illiapliukhin/leds/hardware/analysis/MATRIX_ROUTING_FEASIBILITY.md

# Matrix routing feasibility

Status: all local orientation probes and the complete repeated 20×20 and 28×28 LED matrices pass KiCad 10 DRC. The complete matrices have zero violations and zero unconnected items. Driver exits, backside placement, and the L2 ground zone are not included.

## Verified artifacts

- `wearable_20x20_edge_routing_probe.kicad_pcb`
- `wearable_20x20_edge_routing_probe_drc.rpt`
- `wearable_28x28_edge_routing_probe.kicad_pcb`
- `wearable_28x28_edge_routing_probe_drc.rpt`
- `wearable_20x20_bottom_right_routing_probe.kicad_pcb`
- `wearable_20x20_bottom_right_routing_probe_drc.rpt`
- `wearable_28x28_bottom_right_routing_probe.kicad_pcb`
- `wearable_28x28_bottom_right_routing_probe_drc.rpt`
- `wearable_20x20_orientation_transition_routing_probe.kicad_pcb`
- `wearable_20x20_orientation_transition_routing_probe_drc.rpt`
- `wearable_28x28_orientation_transition_routing_probe.kicad_pcb`
- `wearable_28x28_orientation_transition_routing_probe_drc.rpt`
- `wearable_20x20_top_right_routing_probe.kicad_pcb`
- `wearable_20x20_top_right_routing_probe_drc.rpt`
- `wearable_20x20_bottom_left_routing_probe.kicad_pcb`
- `wearable_20x20_bottom_left_routing_probe_drc.rpt`
- `wearable_28x28_top_right_routing_probe.kicad_pcb`
- `wearable_28x28_top_right_routing_probe_drc.rpt`
- `wearable_28x28_bottom_left_routing_probe.kicad_pcb`
- `wearable_28x28_bottom_left_routing_probe_drc.rpt`
- `wearable_20x20_top_right_column_boundary_routing_probe.kicad_pcb`
- `wearable_20x20_top_right_column_boundary_routing_probe_drc.rpt`
- `wearable_20x20_bottom_left_column_boundary_routing_probe.kicad_pcb`
- `wearable_20x20_bottom_left_column_boundary_routing_probe_drc.rpt`
- `wearable_28x28_top_right_column_boundary_routing_probe.kicad_pcb`
- `wearable_28x28_top_right_column_boundary_routing_probe_drc.rpt`
- `wearable_28x28_bottom_left_column_boundary_routing_probe.kicad_pcb`
- `wearable_28x28_bottom_left_column_boundary_routing_probe_drc.rpt`
- `wearable_20x20_top_right_row_boundary_routing_probe.kicad_pcb`
- `wearable_20x20_top_right_row_boundary_routing_probe_drc.rpt`
- `wearable_20x20_bottom_left_row_boundary_routing_probe.kicad_pcb`
- `wearable_20x20_bottom_left_row_boundary_routing_probe_drc.rpt`
- `wearable_28x28_top_right_row_boundary_routing_probe.kicad_pcb`
- `wearable_28x28_top_right_row_boundary_routing_probe_drc.rpt`
- `wearable_28x28_bottom_left_row_boundary_routing_probe.kicad_pcb`
- `wearable_28x28_bottom_left_row_boundary_routing_probe_drc.rpt`
- `wearable_20x20_full_matrix_routing.kicad_pcb`
- `wearable_20x20_full_matrix_routing_drc.rpt`
- `wearable_28x28_full_matrix_routing.kicad_pcb`
- `wearable_28x28_full_matrix_routing_drc.rpt`
- Generator: `hardware/tools/generate_edge_routing_probe.py`
- Boundary generator: `hardware/tools/generate_orientation_boundary_probes.py`
- Full-matrix generator: `hardware/tools/generate_full_matrix_routing.py`

All 18 local-probe DRC reports contain zero geometric violations. They still report 499 unconnected groups because only four LEDs are routed in each probe. Both full-matrix reports contain `Found 0 DRC violations` and `Found 0 unconnected pads`.

## DRC-proven local pattern

- L1 carries only short LED-pad escape segments.
- Every RGB cathode transitions to L4 with a 0.40/0.20 mm through via.
- L4 carries three 0.10 mm vertical RGB trunks per column.
- Each trunk is offset 0.375 mm from the optical center or runs through the center.
- Every common anode transitions to L3 with a 0.45/0.20 mm through via.
- Interior L3 row buses are 1.20 mm wide.
- The top edge row bus is 0.40 mm wide and centered 0.525 mm from the routed edge.
- Local copper clearance is 0.10 mm.
- Hole-to-copper clearance is 0.20 mm.
- Copper-to-edge clearance is at least 0.30 mm.

The same top-left topology passes at 2.50 mm and 2.20 mm pitch without microvias, blind/buried vias, or via-in-pad.

The bottom-right probe rotates the final two LED rows by 180 degrees and mirrors the escape inward:

- RGB transition vias are above each rotated LED;
- the bottom L3 row bus is 0.40 mm wide and centered 0.525 mm from the edge;
- anode vias escape to the left, including at the rightmost column;
- the same 0.40/0.20 mm RGB and 0.45/0.20 mm anode vias are retained.

The orientation-transition probe uses a normal upper row and a 180-degree lower row. Rotating the footprint reverses the lateral G/R pad order, so three shared RGB vias cannot connect both rows on one copper layer without a crossover. The DRC-proven transition uses:

- one shared blue via per column;
- separate upper and lower G/R vias, for five RGB vias per transition column;
- a local G crossover on L3 and an R crossover on L4;
- a 0.40 mm local neck in each L3 row bus through the transition cell.

The normal 1.20 mm interior row-bus width resumes outside the transition cell. All row buses now use KiCad `In2.Cu`, the physical L3 layer; `In1.Cu` remains reserved for the L2 ground plane.

The mirrored corners require corner-specific quarter-turn orientations:

- top-right LEDs use 90 degrees, with G/B side escapes and a central R escape toward the board interior;
- bottom-left LEDs use 270 degrees with the same topology mirrored vertically;
- anode vias escape inward, retaining the standard 0.45/0.20 mm geometry.

The DRC-proven global orientation map is:

- 0 degrees across the upper interior half;
- 180 degrees across the lower interior half;
- 90 degrees along the upper right edge, transitioning to 180 degrees below;
- 270 degrees along the lower left edge, transitioning from 0 degrees above.

Column-boundary probes prove the upper `0°|90°` and lower `270°|180°` junctions. Row-boundary probes prove the right-edge `90°→180°` and left-edge `0°→270°` junctions. Each edge row transition uses five RGB vias per column: one shared G via and separate B/R vias joined through orthogonal L3/L4 crossover corridors. The two local L3 row buses remain 0.40 mm wide. Both pitches pass without using L2 copper.

## Complete repeated matrix

The full-matrix generator expands the proven orientation map across every LED while adapting the midpoint transitions to the neighboring trunks:

- generation always starts from a clean in-memory skeleton and never consumes
  the working production PCB, so repeated runs cannot duplicate matrix copper;
- `generate_board_skeletons.py` writes reviewable skeletons under
  `hardware/analysis` instead of overwriting working boards;
- generated board/items receive deterministic KiCad UUIDs, and
  `verify_matrix_generation.py` compares SHA-256 across two complete runs
  before applying the promotion topology checks;
- standard midpoint cells keep G on L3, R on L4, and B continuity on L1;
- edge midpoint cells use one L3 crossover, one short L4 crossover, and separated L4 doglegs around the row vias;
- regular L4 RGB trunks resume outside each transition cell;
- all row buses remain on L3, with only short L1 anode escapes;
- L2 contains no generated tracks.

KiCad semantic checks confirm:

| Check | 20×20 | 28×28 |
|---|---:|---:|
| LED footprints | 400 | 784 |
| Total through vias | 1,564 | 3,084 |
| Row vias, 0.45/0.20 mm | 400 | 784 |
| RGB vias, 0.40/0.20 mm | 1,164 | 2,300 |
| Row nets present on L3 | 20 | 28 |
| Tracks on L2 | 0 | 0 |

The orientation counts are 180/20/180/20 for 0°/90°/180°/270° on 20×20 and 364/28/364/28 on 28×28. Every generated via is a standard through via with a 0.20 mm drill. Promotion rejects any mismatch in LED-only footprint scope, orientation counts, total tracks/vias, 0.40/0.45 mm via counts, drill size, L3 row-net coverage, L2 occupancy, or connectivity.

## Preliminary electrical estimate

Assumptions:

- copper resistivity: 1.724 × 10⁻⁸ Ω·m;
- L3 inner copper: conservative 17.5 µm;
- L4 outer copper: 35 µm;
- row current: 0.60 A for 20×20 and 0.84 A for 28×28;
- current is distributed uniformly along a row and fed from one end;
- one active LED color channel carries 10 mA.

| Case | Approximate conductor resistance | Distributed-load far-end drop |
|---|---:|---:|
| 20×20, 0.40 mm outer row | 0.117 Ω | 35 mV |
| 20×20, 1.20 mm interior row | 0.039 Ω | 12 mV |
| 28×28, 0.40 mm outer row | 0.146 Ω | 61 mV |
| 28×28, 1.20 mm interior row | 0.049 Ω | 21 mV |
| 28×28, 0.10 mm RGB trunk | 0.293 Ω | 2.9 mV at 10 mA |

These are first-order copper-only estimates. PMOS, connector, via, plane-spreading, converter ripple, copper-thickness tolerance, and temperature are excluded. Feed rows from both ends if backside placement permits; otherwise confirm the farthest blue pixel at maximum row current during EVT.

## Density and production impact

The DRC-clean repeated topology uses fewer than four matrix vias per LED because midpoint transition cells share or avoid selected RGB vias:

- 20×20: 1,564 matrix vias;
- 28×28: 3,084 matrix vias.

This is a conventional through-via process but creates substantial L2 ground-plane perforation and drill count. Before production layout:

1. confirm JLCPCB accepts the repeated 0.40/0.20 mm vias at quoted yield;
2. inspect L2 neck widths and return-current continuity after antipads;
3. reserve L4 vertical channels from backside component pads;
4. add row feeds and RGB driver exits without blocking the proven corridors;
5. compare against a lower-via interior pattern only if it remains simpler and DRC-clean.

`hardware/tools/add_l2_ground_plane.py` generates a non-production 20×20
probe with a 0.30 mm edge inset and 0.10 mm clearance/minimum thickness.
After all 1,564 matrix-via antipads are applied, KiCad reports one contiguous
fill outline, 1,919.9 mm² of copper, and 81.0% coverage of the nominal zone.
The probe intentionally retains an isolated-copper warning because no
backside GND pad exists yet. This proves gross geometric continuity only; it
does not prove electrical grounding, local return-path quality, or minimum
neck width after component placement.

## Release gate

Do not treat the DRC-clean repeated matrix as production output until:

- row feeds, driver exits, and backside placement are included;
- L2 plane continuity is reviewed visually and by field-current inspection;
- voltage-drop assumptions are checked against the selected supplier stackup.
