illiapliukhin/leds/hardware/analysis/POWER_SCAN_MODEL.md

# Wearable RGB power and scan model

Generated by `hardware/tools/model_power_scan.py`.

## Assumptions

- LED rail: 4.099 V.
- Peak channel current: 9.41 mA.
- Six color-homogeneous drivers and 96 serialized bits per row.
- Physical PWM depth: 6 bits.
- SPI clock: 20.0 MHz.
- Row transition dead time: 1.5 us per bit-plane row.
- AO3403 preliminary worst-case resistance: 200 mOhm.
- Battery-current and converter-temperature calculations use 90% efficiency at 3.15 V.
- TPS63802 open-board temperature rise uses datasheet RthetaJA = 81 C/W. It is not an enclosure prediction.

## Results

| Variant | Row current | LED rail power | PMOS drop | Battery current at 3.15 V | LSB / MSB hold | 1 W brightness cap |
|---|---:|---:|---:|---:|---:|---:|
| wearable_20x20 | 0.565 A | 2.32 W | 113 mV | 0.82 A | 3.94 / 125.9 us | 43% |
| wearable_28x28 | 0.791 A | 3.24 W | 158 mV | 1.14 A | 4.33 / 138.5 us | 31% |

## Engineering conclusions

- Full-white operation exceeds the 1–1.2 W wearable continuous target on both variants. Global brightness and content-aware power limiting are mandatory.
- The high-resolution variant needs roughly 1.14 A from a 3.15 V battery at the assumed efficiency. Battery, connector, charger power path, copper, and converter transients must support this pulse current.
- The conservative AO3403 drop is large enough to affect LED headroom. Measure row voltage and color current at hot and cold temperature before freezing LED_4V1.
- The 20 MHz scan timing budget remains positive with 1.5 us break-before-make dead time. Confirm the dead time from gate and row waveforms on EVT.
- Converter junction-rise values are screening estimates only. Use enclosure thermal measurements to set firmware derating.
