illiapliukhin/leds/hardware/analysis/power_scan_results.csv

variant | peak_row_current_a | led_rail_power_w | pmos_drop_v | aggregate_pmos_loss_w | shift_time_per_frame_us | blank_time_per_frame_us | lsb_hold_time_us | msb_hold_time_us | battery_current_min_v_a | converter_loss_w | converter_open_board_rise_c | brightness_limit_at_1w | brightness_limit_at_1_2w
wearable_20x20 | 0.564795918367347 | 2.3150984693877557 | 0.11295918367346941 | 0.06379888588088299 | 576.0 | 180.0 | 3.93514739229025 | 125.924716553288 | 0.8166132167152578 | 0.2572331632653063 | 20.835886224489812 | 0.43194706973498936 | 0.5183364836819871
wearable_28x28 | 0.7907142857142857 | 3.2411378571428573 | 0.15814285714285714 | 0.1250458163265306 | 806.4 | 252.0 | 4.3295080350980975 | 138.54425712313912 | 1.1432585034013607 | 0.36012642857142874 | 29.17024071428573 | 0.3085336212392782 | 0.3702403454871338
