illiapliukhin/leds/hardware/wearable_28x28/wearable_28x28.kicad_pcb

## KiCad design hardware/wearable_28x28/wearable_28x28.kicad_pcb (2026-10-08)

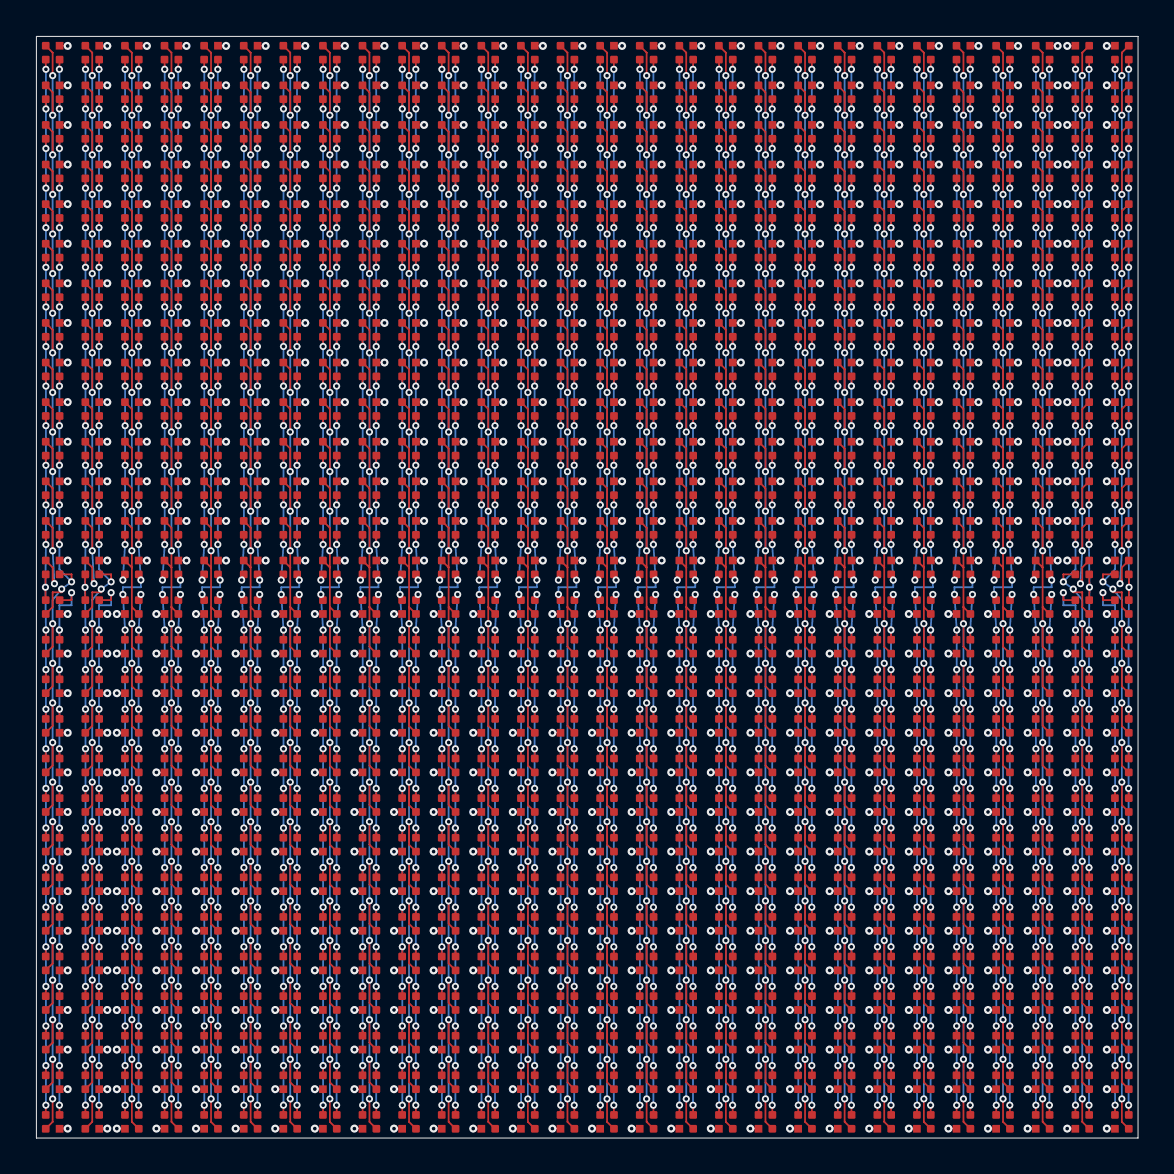
[picture p3: board wearable_28x28.kicad_pcb from above]

Board: 4 copper layers, 61.2 x 61.2 mm, 784 parts (0 on the bottom side), 112 nets.

Parts:
D1, D2, D3, D4, D5, D6, D7, D8, D9, D10, D11, D12, D13, D14, D15, D16, D17, D18, D19, D20, D21, D22, D23, D24, D25, D26, D27, D28, D29, D30, D31, D32, D33, D34, D35, D36, D37, D38, D39, D40, D41, D42, D43, D44, D45, D46, D47, D48, D49, D50, D51, D52, D53, D54, D55, D56, D57, D58, D59, D60, D61, D62, D63, D64, D65, D66, D67, D68, D69, D70, D71, D72, D73, D74, D75, D76, D77, D78, D79, D80, D81, D82, D83, D84, D85, D86, D87, D88, D89, D90, D91, D92, D93, D94, D95, D96, D97, D98, D99, D100, D101, D102, D103, D104, D105, D106, D107, D108, D109, D110, D111, D112, D113, D114, D115, D116, D117, D118, D119, D120, D121, D122, D123, D124, D125, D126, D127, D128, D129, D130, D131, D132, D133, D134, D135, D136, D137, D138, D139, D140, D141, D142, D143, D144, D145, D146, D147, D148, D149, D150, D151, D152, D153, D154, D155, D156, D157, D158, D159, D160, D161, D162, D163, D164, D165, D166, D167, D168, D169, D170, D171, D172, D173, D174, D175, D176, D177, D178, D179, D180, D181, D182, D183, D184, D185, D186, D187, D188, D189, D190, D191, D192, D193, D194, D195, D196, D197, D198, D199, D200, D201, D202, D203, D204, D205, D206, D207, D208, D209, D210, D211, D212, D213, D214, D215, D216, D217, D218, D219, D220, D221, D222, D223, D224, D225, D226, D227, D228, D229, D230, D231, D232, D233, D234, D235, D236, D237, D238, D239, D240, D241, D242, D243, D244, D245, D246, D247, D248, D249, D250, D251, D252, D253, D254, D255, D256, D257, D258, D259, D260, D261, D262, D263, D264, D265, D266, D267, D268, D269, D270, D271, D272, D273, D274, D275, D276, D277, D278, D279, D280, D281, D282, D283, D284, D285, D286, D287, D288, D289, D290, D291, D292, D293, D294, D295, D296, D297, D298, D299, D300, D301, D302, D303, D304, D305, D306, D307, D308, D309, D310, D311, D312, D313, D314, D315, D316, D317, D318, D319, D320, D321, D322, D323, D324, D325, D326, D327, D328, D329, D330, D331, D332, D333, D334, D335, D336, D337, D338, D339, D340, D341, D342, D343, D344, D345, D346, D347, D348, D349, D350, D351, D352, D353, D354, D355, D356, D357, D358, D359, D360, D361, D362, D363, D364, D365, D366, D367, D368, D369, D370, D371, D372, D373, D374, D375, D376, D377, D378, D379, D380, D381, D382, D383, D384, D385, D386, D387, D388, D389, D390, D391, D392, D393, D394, D395, D396, D397, D398, D399, D400, D401, D402, D403, D404, D405, D406, D407, D408, D409, D410, D411, D412, D413, D414, D415, D416, D417, D418, D419, D420, D421, D422, D423, D424, D425, D426, D427, D428, D429, D430, D431, D432, D433, D434, D435, D436, D437, D438, D439, D440, D441, D442, D443, D444, D445, D446, D447, D448, D449, D450, D451, D452, D453, D454, D455, D456, D457, D458, D459, D460, D461, D462, D463, D464, D465, D466, D467, D468, D469, D470, D471, D472, D473, D474, D475, D476, D477, D478, D479, D480, D481, D482, D483, D484, D485, D486, D487, D488, D489, D490, D491, D492, D493, D494, D495, D496, D497, D498, D499, D500, D501, D502, D503, D504, D505, D506, D507, D508, D509, D510, D511, D512, D513, D514, D515, D516, D517, D518, D519, D520, D521, D522, D523, D524, D525, D526, D527, D528, D529, D530, D531, D532, D533, D534, D535, D536, D537, D538, D539, D540, D541, D542, D543, D544, D545, D546, D547, D548, D549, D550, D551, D552, D553, D554, D555, D556, D557, D558, D559, D560, D561, D562, D563, D564, D565, D566, D567, D568, D569, D570, D571, D572, D573, D574, D575, D576, D577, D578, D579, D580, D581, D582, D583, D584, D585, D586, D587, D588, D589, D590, D591, D592, D593, D594, D595, D596, D597, D598, D599, D600, D601, D602, D603, D604, D605, D606, D607, D608, D609, D610, D611, D612, D613, D614, D615, D616, D617, D618, D619, D620, D621, D622, D623, D624, D625, D626, D627, D628, D629, D630, D631, D632, D633, D634, D635, D636, D637, D638, D639, D640, D641, D642, D643, D644, D645, D646, D647, D648, D649, D650, D651, D652, D653, D654, D655, D656, D657, D658, D659, D660, D661, D662, D663, D664, D665, D666, D667, D668, D669, D670, D671, D672, D673, D674, D675, D676, D677, D678, D679, D680, D681, D682, D683, D684, D685, D686, D687, D688, D689, D690, D691, D692, D693, D694, D695, D696, D697, D698, D699, D700, D701, D702, D703, D704, D705, D706, D707, D708, D709, D710, D711, D712, D713, D714, D715, D716, D717, D718, D719, D720, D721, D722, D723, D724, D725, D726, D727, D728, D729, D730, D731, D732, D733, D734, D735, D736, D737, D738, D739, D740, D741, D742, D743, D744, D745, D746, D747, D748, D749, D750, D751, D752, D753, D754, D755, D756, D757, D758, D759, D760, D761, D762, D763, D764, D765, D766, D767, D768, D769, D770, D771, D772, D773, D774, D775, D776, D777, D778, D779, D780, D781, D782, D783, D784: MHPA1010RGBDT

Connections:
COL_B_01: D1.4 (K_B), D29.4 (K_B), D57.4 (K_B), D85.4 (K_B), D113.4 (K_B), D141.4 (K_B), D169.4 (K_B), D197.4 (K_B), D225.4 (K_B), D253.4 (K_B), D281.4 (K_B), D309.4 (K_B), D337.4 (K_B), D365.4 (K_B), D393.4 (K_B), D421.4 (K_B), D449.4 (K_B), D477.4 (K_B), D505.4 (K_B), D533.4 (K_B), D561.4 (K_B), D589.4 (K_B), D617.4 (K_B), D645.4 (K_B), D673.4 (K_B), D701.4 (K_B), D729.4 (K_B), D757.4 (K_B)
COL_B_02: D2.4 (K_B), D30.4 (K_B), D58.4 (K_B), D86.4 (K_B), D114.4 (K_B), D142.4 (K_B), D170.4 (K_B), D198.4 (K_B), D226.4 (K_B), D254.4 (K_B), D282.4 (K_B), D310.4 (K_B), D338.4 (K_B), D366.4 (K_B), D394.4 (K_B), D422.4 (K_B), D450.4 (K_B), D478.4 (K_B), D506.4 (K_B), D534.4 (K_B), D562.4 (K_B), D590.4 (K_B), D618.4 (K_B), D646.4 (K_B), D674.4 (K_B), D702.4 (K_B), D730.4 (K_B), D758.4 (K_B)
COL_B_03: D3.4 (K_B), D31.4 (K_B), D59.4 (K_B), D87.4 (K_B), D115.4 (K_B), D143.4 (K_B), D171.4 (K_B), D199.4 (K_B), D227.4 (K_B), D255.4 (K_B), D283.4 (K_B), D311.4 (K_B), D339.4 (K_B), D367.4 (K_B), D395.4 (K_B), D423.4 (K_B), D451.4 (K_B), D479.4 (K_B), D507.4 (K_B), D535.4 (K_B), D563.4 (K_B), D591.4 (K_B), D619.4 (K_B), D647.4 (K_B), D675.4 (K_B), D703.4 (K_B), D731.4 (K_B), D759.4 (K_B)
COL_B_04: D4.4 (K_B), D32.4 (K_B), D60.4 (K_B), D88.4 (K_B), D116.4 (K_B), D144.4 (K_B), D172.4 (K_B), D200.4 (K_B), D228.4 (K_B), D256.4 (K_B), D284.4 (K_B), D312.4 (K_B), D340.4 (K_B), D368.4 (K_B), D396.4 (K_B), D424.4 (K_B), D452.4 (K_B), D480.4 (K_B), D508.4 (K_B), D536.4 (K_B), D564.4 (K_B), D592.4 (K_B), D620.4 (K_B), D648.4 (K_B), D676.4 (K_B), D704.4 (K_B), D732.4 (K_B), D760.4 (K_B)
COL_B_05: D5.4 (K_B), D33.4 (K_B), D61.4 (K_B), D89.4 (K_B), D117.4 (K_B), D145.4 (K_B), D173.4 (K_B), D201.4 (K_B), D229.4 (K_B), D257.4 (K_B), D285.4 (K_B), D313.4 (K_B), D341.4 (K_B), D369.4 (K_B), D397.4 (K_B), D425.4 (K_B), D453.4 (K_B), D481.4 (K_B), D509.4 (K_B), D537.4 (K_B), D565.4 (K_B), D593.4 (K_B), D621.4 (K_B), D649.4 (K_B), D677.4 (K_B), D705.4 (K_B), D733.4 (K_B), D761.4 (K_B)
COL_B_06: D6.4 (K_B), D34.4 (K_B), D62.4 (K_B), D90.4 (K_B), D118.4 (K_B), D146.4 (K_B), D174.4 (K_B), D202.4 (K_B), D230.4 (K_B), D258.4 (K_B), D286.4 (K_B), D314.4 (K_B), D342.4 (K_B), D370.4 (K_B), D398.4 (K_B), D426.4 (K_B), D454.4 (K_B), D482.4 (K_B), D510.4 (K_B), D538.4 (K_B), D566.4 (K_B), D594.4 (K_B), D622.4 (K_B), D650.4 (K_B), D678.4 (K_B), D706.4 (K_B), D734.4 (K_B), D762.4 (K_B)
COL_B_07: D7.4 (K_B), D35.4 (K_B), D63.4 (K_B), D91.4 (K_B), D119.4 (K_B), D147.4 (K_B), D175.4 (K_B), D203.4 (K_B), D231.4 (K_B), D259.4 (K_B), D287.4 (K_B), D315.4 (K_B), D343.4 (K_B), D371.4 (K_B), D399.4 (K_B), D427.4 (K_B), D455.4 (K_B), D483.4 (K_B), D511.4 (K_B), D539.4 (K_B), D567.4 (K_B), D595.4 (K_B), D623.4 (K_B), D651.4 (K_B), D679.4 (K_B), D707.4 (K_B), D735.4 (K_B), D763.4 (K_B)
COL_B_08: D8.4 (K_B), D36.4 (K_B), D64.4 (K_B), D92.4 (K_B), D120.4 (K_B), D148.4 (K_B), D176.4 (K_B), D204.4 (K_B), D232.4 (K_B), D260.4 (K_B), D288.4 (K_B), D316.4 (K_B), D344.4 (K_B), D372.4 (K_B), D400.4 (K_B), D428.4 (K_B), D456.4 (K_B), D484.4 (K_B), D512.4 (K_B), D540.4 (K_B), D568.4 (K_B), D596.4 (K_B), D624.4 (K_B), D652.4 (K_B), D680.4 (K_B), D708.4 (K_B), D736.4 (K_B), D764.4 (K_B)
COL_B_09: D9.4 (K_B), D37.4 (K_B), D65.4 (K_B), D93.4 (K_B), D121.4 (K_B), D149.4 (K_B), D177.4 (K_B), D205.4 (K_B), D233.4 (K_B), D261.4 (K_B), D289.4 (K_B), D317.4 (K_B), D345.4 (K_B), D373.4 (K_B), D401.4 (K_B), D429.4 (K_B), D457.4 (K_B), D485.4 (K_B), D513.4 (K_B), D541.4 (K_B), D569.4 (K_B), D597.4 (K_B), D625.4 (K_B), D653.4 (K_B), D681.4 (K_B), D709.4 (K_B), D737.4 (K_B), D765.4 (K_B)
COL_B_10: D10.4 (K_B), D38.4 (K_B), D66.4 (K_B), D94.4 (K_B), D122.4 (K_B), D150.4 (K_B), D178.4 (K_B), D206.4 (K_B), D234.4 (K_B), D262.4 (K_B), D290.4 (K_B), D318.4 (K_B), D346.4 (K_B), D374.4 (K_B), D402.4 (K_B), D430.4 (K_B), D458.4 (K_B), D486.4 (K_B), D514.4 (K_B), D542.4 (K_B), D570.4 (K_B), D598.4 (K_B), D626.4 (K_B), D654.4 (K_B), D682.4 (K_B), D710.4 (K_B), D738.4 (K_B), D766.4 (K_B)
COL_B_11: D11.4 (K_B), D39.4 (K_B), D67.4 (K_B), D95.4 (K_B), D123.4 (K_B), D151.4 (K_B), D179.4 (K_B), D207.4 (K_B), D235.4 (K_B), D263.4 (K_B), D291.4 (K_B), D319.4 (K_B), D347.4 (K_B), D375.4 (K_B), D403.4 (K_B), D431.4 (K_B), D459.4 (K_B), D487.4 (K_B), D515.4 (K_B), D543.4 (K_B), D571.4 (K_B), D599.4 (K_B), D627.4 (K_B), D655.4 (K_B), D683.4 (K_B), D711.4 (K_B), D739.4 (K_B), D767.4 (K_B)
COL_B_12: D12.4 (K_B), D40.4 (K_B), D68.4 (K_B), D96.4 (K_B), D124.4 (K_B), D152.4 (K_B), D180.4 (K_B), D208.4 (K_B), D236.4 (K_B), D264.4 (K_B), D292.4 (K_B), D320.4 (K_B), D348.4 (K_B), D376.4 (K_B), D404.4 (K_B), D432.4 (K_B), D460.4 (K_B), D488.4 (K_B), D516.4 (K_B), D544.4 (K_B), D572.4 (K_B), D600.4 (K_B), D628.4 (K_B), D656.4 (K_B), D684.4 (K_B), D712.4 (K_B), D740.4 (K_B), D768.4 (K_B)
COL_B_13: D13.4 (K_B), D41.4 (K_B), D69.4 (K_B), D97.4 (K_B), D125.4 (K_B), D153.4 (K_B), D181.4 (K_B), D209.4 (K_B), D237.4 (K_B), D265.4 (K_B), D293.4 (K_B), D321.4 (K_B), D349.4 (K_B), D377.4 (K_B), D405.4 (K_B), D433.4 (K_B), D461.4 (K_B), D489.4 (K_B), D517.4 (K_B), D545.4 (K_B), D573.4 (K_B), D601.4 (K_B), D629.4 (K_B), D657.4 (K_B), D685.4 (K_B), D713.4 (K_B), D741.4 (K_B), D769.4 (K_B)
COL_B_14: D14.4 (K_B), D42.4 (K_B), D70.4 (K_B), D98.4 (K_B), D126.4 (K_B), D154.4 (K_B), D182.4 (K_B), D210.4 (K_B), D238.4 (K_B), D266.4 (K_B), D294.4 (K_B), D322.4 (K_B), D350.4 (K_B), D378.4 (K_B), D406.4 (K_B), D434.4 (K_B), D462.4 (K_B), D490.4 (K_B), D518.4 (K_B), D546.4 (K_B), D574.4 (K_B), D602.4 (K_B), D630.4 (K_B), D658.4 (K_B), D686.4 (K_B), D714.4 (K_B), D742.4 (K_B), D770.4 (K_B)
COL_B_15: D15.4 (K_B), D43.4 (K_B), D71.4 (K_B), D99.4 (K_B), D127.4 (K_B), D155.4 (K_B), D183.4 (K_B), D211.4 (K_B), D239.4 (K_B), D267.4 (K_B), D295.4 (K_B), D323.4 (K_B), D351.4 (K_B), D379.4 (K_B), D407.4 (K_B), D435.4 (K_B), D463.4 (K_B), D491.4 (K_B), D519.4 (K_B), D547.4 (K_B), D575.4 (K_B), D603.4 (K_B), D631.4 (K_B), D659.4 (K_B), D687.4 (K_B), D715.4 (K_B), D743.4 (K_B), D771.4 (K_B)
COL_B_16: D16.4 (K_B), D44.4 (K_B), D72.4 (K_B), D100.4 (K_B), D128.4 (K_B), D156.4 (K_B), D184.4 (K_B), D212.4 (K_B), D240.4 (K_B), D268.4 (K_B), D296.4 (K_B), D324.4 (K_B), D352.4 (K_B), D380.4 (K_B), D408.4 (K_B), D436.4 (K_B), D464.4 (K_B), D492.4 (K_B), D520.4 (K_B), D548.4 (K_B), D576.4 (K_B), D604.4 (K_B), D632.4 (K_B), D660.4 (K_B), D688.4 (K_B), D716.4 (K_B), D744.4 (K_B), D772.4 (K_B)
COL_B_17: D17.4 (K_B), D45.4 (K_B), D73.4 (K_B), D101.4 (K_B), D129.4 (K_B), D157.4 (K_B), D185.4 (K_B), D213.4 (K_B), D241.4 (K_B), D269.4 (K_B), D297.4 (K_B), D325.4 (K_B), D353.4 (K_B), D381.4 (K_B), D409.4 (K_B), D437.4 (K_B), D465.4 (K_B), D493.4 (K_B), D521.4 (K_B), D549.4 (K_B), D577.4 (K_B), D605.4 (K_B), D633.4 (K_B), D661.4 (K_B), D689.4 (K_B), D717.4 (K_B), D745.4 (K_B), D773.4 (K_B)
COL_B_18: D18.4 (K_B), D46.4 (K_B), D74.4 (K_B), D102.4 (K_B), D130.4 (K_B), D158.4 (K_B), D186.4 (K_B), D214.4 (K_B), D242.4 (K_B), D270.4 (K_B), D298.4 (K_B), D326.4 (K_B), D354.4 (K_B), D382.4 (K_B), D410.4 (K_B), D438.4 (K_B), D466.4 (K_B), D494.4 (K_B), D522.4 (K_B), D550.4 (K_B), D578.4 (K_B), D606.4 (K_B), D634.4 (K_B), D662.4 (K_B), D690.4 (K_B), D718.4 (K_B), D746.4 (K_B), D774.4 (K_B)
COL_B_19: D19.4 (K_B), D47.4 (K_B), D75.4 (K_B), D103.4 (K_B), D131.4 (K_B), D159.4 (K_B), D187.4 (K_B), D215.4 (K_B), D243.4 (K_B), D271.4 (K_B), D299.4 (K_B), D327.4 (K_B), D355.4 (K_B), D383.4 (K_B), D411.4 (K_B), D439.4 (K_B), D467.4 (K_B), D495.4 (K_B), D523.4 (K_B), D551.4 (K_B), D579.4 (K_B), D607.4 (K_B), D635.4 (K_B), D663.4 (K_B), D691.4 (K_B), D719.4 (K_B), D747.4 (K_B), D775.4 (K_B)
COL_B_20: D20.4 (K_B), D48.4 (K_B), D76.4 (K_B), D104.4 (K_B), D132.4 (K_B), D160.4 (K_B), D188.4 (K_B), D216.4 (K_B), D244.4 (K_B), D272.4 (K_B), D300.4 (K_B), D328.4 (K_B), D356.4 (K_B), D384.4 (K_B), D412.4 (K_B), D440.4 (K_B), D468.4 (K_B), D496.4 (K_B), D524.4 (K_B), D552.4 (K_B), D580.4 (K_B), D608.4 (K_B), D636.4 (K_B), D664.4 (K_B), D692.4 (K_B), D720.4 (K_B), D748.4 (K_B), D776.4 (K_B)
COL_B_21: D21.4 (K_B), D49.4 (K_B), D77.4 (K_B), D105.4 (K_B), D133.4 (K_B), D161.4 (K_B), D189.4 (K_B), D217.4 (K_B), D245.4 (K_B), D273.4 (K_B), D301.4 (K_B), D329.4 (K_B), D357.4 (K_B), D385.4 (K_B), D413.4 (K_B), D441.4 (K_B), D469.4 (K_B), D497.4 (K_B), D525.4 (K_B), D553.4 (K_B), D581.4 (K_B), D609.4 (K_B), D637.4 (K_B), D665.4 (K_B), D693.4 (K_B), D721.4 (K_B), D749.4 (K_B), D777.4 (K_B)
COL_B_22: D22.4 (K_B), D50.4 (K_B), D78.4 (K_B), D106.4 (K_B), D134.4 (K_B), D162.4 (K_B), D190.4 (K_B), D218.4 (K_B), D246.4 (K_B), D274.4 (K_B), D302.4 (K_B), D330.4 (K_B), D358.4 (K_B), D386.4 (K_B), D414.4 (K_B), D442.4 (K_B), D470.4 (K_B), D498.4 (K_B), D526.4 (K_B), D554.4 (K_B), D582.4 (K_B), D610.4 (K_B), D638.4 (K_B), D666.4 (K_B), D694.4 (K_B), D722.4 (K_B), D750.4 (K_B), D778.4 (K_B)
COL_B_23: D23.4 (K_B), D51.4 (K_B), D79.4 (K_B), D107.4 (K_B), D135.4 (K_B), D163.4 (K_B), D191.4 (K_B), D219.4 (K_B), D247.4 (K_B), D275.4 (K_B), D303.4 (K_B), D331.4 (K_B), D359.4 (K_B), D387.4 (K_B), D415.4 (K_B), D443.4 (K_B), D471.4 (K_B), D499.4 (K_B), D527.4 (K_B), D555.4 (K_B), D583.4 (K_B), D611.4 (K_B), D639.4 (K_B), D667.4 (K_B), D695.4 (K_B), D723.4 (K_B), D751.4 (K_B), D779.4 (K_B)
COL_B_24: D24.4 (K_B), D52.4 (K_B), D80.4 (K_B), D108.4 (K_B), D136.4 (K_B), D164.4 (K_B), D192.4 (K_B), D220.4 (K_B), D248.4 (K_B), D276.4 (K_B), D304.4 (K_B), D332.4 (K_B), D360.4 (K_B), D388.4 (K_B), D416.4 (K_B), D444.4 (K_B), D472.4 (K_B), D500.4 (K_B), D528.4 (K_B), D556.4 (K_B), D584.4 (K_B), D612.4 (K_B), D640.4 (K_B), D668.4 (K_B), D696.4 (K_B), D724.4 (K_B), D752.4 (K_B), D780.4 (K_B)
COL_B_25: D25.4 (K_B), D53.4 (K_B), D81.4 (K_B), D109.4 (K_B), D137.4 (K_B), D165.4 (K_B), D193.4 (K_B), D221.4 (K_B), D249.4 (K_B), D277.4 (K_B), D305.4 (K_B), D333.4 (K_B), D361.4 (K_B), D389.4 (K_B), D417.4 (K_B), D445.4 (K_B), D473.4 (K_B), D501.4 (K_B), D529.4 (K_B), D557.4 (K_B), D585.4 (K_B), D613.4 (K_B), D641.4 (K_B), D669.4 (K_B), D697.4 (K_B), D725.4 (K_B), D753.4 (K_B), D781.4 (K_B)
COL_B_26: D26.4 (K_B), D54.4 (K_B), D82.4 (K_B), D110.4 (K_B), D138.4 (K_B), D166.4 (K_B), D194.4 (K_B), D222.4 (K_B), D250.4 (K_B), D278.4 (K_B), D306.4 (K_B), D334.4 (K_B), D362.4 (K_B), D390.4 (K_B), D418.4 (K_B), D446.4 (K_B), D474.4 (K_B), D502.4 (K_B), D530.4 (K_B), D558.4 (K_B), D586.4 (K_B), D614.4 (K_B), D642.4 (K_B), D670.4 (K_B), D698.4 (K_B), D726.4 (K_B), D754.4 (K_B), D782.4 (K_B)
COL_B_27: D27.4 (K_B), D55.4 (K_B), D83.4 (K_B), D111.4 (K_B), D139.4 (K_B), D167.4 (K_B), D195.4 (K_B), D223.4 (K_B), D251.4 (K_B), D279.4 (K_B), D307.4 (K_B), D335.4 (K_B), D363.4 (K_B), D391.4 (K_B), D419.4 (K_B), D447.4 (K_B), D475.4 (K_B), D503.4 (K_B), D531.4 (K_B), D559.4 (K_B), D587.4 (K_B), D615.4 (K_B), D643.4 (K_B), D671.4 (K_B), D699.4 (K_B), D727.4 (K_B), D755.4 (K_B), D783.4 (K_B)
COL_B_28: D28.4 (K_B), D56.4 (K_B), D84.4 (K_B), D112.4 (K_B), D140.4 (K_B), D168.4 (K_B), D196.4 (K_B), D224.4 (K_B), D252.4 (K_B), D280.4 (K_B), D308.4 (K_B), D336.4 (K_B), D364.4 (K_B), D392.4 (K_B), D420.4 (K_B), D448.4 (K_B), D476.4 (K_B), D504.4 (K_B), D532.4 (K_B), D560.4 (K_B), D588.4 (K_B), D616.4 (K_B), D644.4 (K_B), D672.4 (K_B), D700.4 (K_B), D728.4 (K_B), D756.4 (K_B), D784.4 (K_B)
COL_G_01: D1.3 (K_G), D29.3 (K_G), D57.3 (K_G), D85.3 (K_G), D113.3 (K_G), D141.3 (K_G), D169.3 (K_G), D197.3 (K_G), D225.3 (K_G), D253.3 (K_G), D281.3 (K_G), D309.3 (K_G), D337.3 (K_G), D365.3 (K_G), D393.3 (K_G), D421.3 (K_G), D449.3 (K_G), D477.3 (K_G), D505.3 (K_G), D533.3 (K_G), D561.3 (K_G), D589.3 (K_G), D617.3 (K_G), D645.3 (K_G), D673.3 (K_G), D701.3 (K_G), D729.3 (K_G), D757.3 (K_G)
COL_G_02: D2.3 (K_G), D30.3 (K_G), D58.3 (K_G), D86.3 (K_G), D114.3 (K_G), D142.3 (K_G), D170.3 (K_G), D198.3 (K_G), D226.3 (K_G), D254.3 (K_G), D282.3 (K_G), D310.3 (K_G), D338.3 (K_G), D366.3 (K_G), D394.3 (K_G), D422.3 (K_G), D450.3 (K_G), D478.3 (K_G), D506.3 (K_G), D534.3 (K_G), D562.3 (K_G), D590.3 (K_G), D618.3 (K_G), D646.3 (K_G), D674.3 (K_G), D702.3 (K_G), D730.3 (K_G), D758.3 (K_G)
COL_G_03: D3.3 (K_G), D31.3 (K_G), D59.3 (K_G), D87.3 (K_G), D115.3 (K_G), D143.3 (K_G), D171.3 (K_G), D199.3 (K_G), D227.3 (K_G), D255.3 (K_G), D283.3 (K_G), D311.3 (K_G), D339.3 (K_G), D367.3 (K_G), D395.3 (K_G), D423.3 (K_G), D451.3 (K_G), D479.3 (K_G), D507.3 (K_G), D535.3 (K_G), D563.3 (K_G), D591.3 (K_G), D619.3 (K_G), D647.3 (K_G), D675.3 (K_G), D703.3 (K_G), D731.3 (K_G), D759.3 (K_G)
COL_G_04: D4.3 (K_G), D32.3 (K_G), D60.3 (K_G), D88.3 (K_G), D116.3 (K_G), D144.3 (K_G), D172.3 (K_G), D200.3 (K_G), D228.3 (K_G), D256.3 (K_G), D284.3 (K_G), D312.3 (K_G), D340.3 (K_G), D368.3 (K_G), D396.3 (K_G), D424.3 (K_G), D452.3 (K_G), D480.3 (K_G), D508.3 (K_G), D536.3 (K_G), D564.3 (K_G), D592.3 (K_G), D620.3 (K_G), D648.3 (K_G), D676.3 (K_G), D704.3 (K_G), D732.3 (K_G), D760.3 (K_G)
COL_G_05: D5.3 (K_G), D33.3 (K_G), D61.3 (K_G), D89.3 (K_G), D117.3 (K_G), D145.3 (K_G), D173.3 (K_G), D201.3 (K_G), D229.3 (K_G), D257.3 (K_G), D285.3 (K_G), D313.3 (K_G), D341.3 (K_G), D369.3 (K_G), D397.3 (K_G), D425.3 (K_G), D453.3 (K_G), D481.3 (K_G), D509.3 (K_G), D537.3 (K_G), D565.3 (K_G), D593.3 (K_G), D621.3 (K_G), D649.3 (K_G), D677.3 (K_G), D705.3 (K_G), D733.3 (K_G), D761.3 (K_G)
COL_G_06: D6.3 (K_G), D34.3 (K_G), D62.3 (K_G), D90.3 (K_G), D118.3 (K_G), D146.3 (K_G), D174.3 (K_G), D202.3 (K_G), D230.3 (K_G), D258.3 (K_G), D286.3 (K_G), D314.3 (K_G), D342.3 (K_G), D370.3 (K_G), D398.3 (K_G), D426.3 (K_G), D454.3 (K_G), D482.3 (K_G), D510.3 (K_G), D538.3 (K_G), D566.3 (K_G), D594.3 (K_G), D622.3 (K_G), D650.3 (K_G), D678.3 (K_G), D706.3 (K_G), D734.3 (K_G), D762.3 (K_G)
COL_G_07: D7.3 (K_G), D35.3 (K_G), D63.3 (K_G), D91.3 (K_G), D119.3 (K_G), D147.3 (K_G), D175.3 (K_G), D203.3 (K_G), D231.3 (K_G), D259.3 (K_G), D287.3 (K_G), D315.3 (K_G), D343.3 (K_G), D371.3 (K_G), D399.3 (K_G), D427.3 (K_G), D455.3 (K_G), D483.3 (K_G), D511.3 (K_G), D539.3 (K_G), D567.3 (K_G), D595.3 (K_G), D623.3 (K_G), D651.3 (K_G), D679.3 (K_G), D707.3 (K_G), D735.3 (K_G), D763.3 (K_G)
COL_G_08: D8.3 (K_G), D36.3 (K_G), D64.3 (K_G), D92.3 (K_G), D120.3 (K_G), D148.3 (K_G), D176.3 (K_G), D204.3 (K_G), D232.3 (K_G), D260.3 (K_G), D288.3 (K_G), D316.3 (K_G), D344.3 (K_G), D372.3 (K_G), D400.3 (K_G), D428.3 (K_G), D456.3 (K_G), D484.3 (K_G), D512.3 (K_G), D540.3 (K_G), D568.3 (K_G), D596.3 (K_G), D624.3 (K_G), D652.3 (K_G), D680.3 (K_G), D708.3 (K_G), D736.3 (K_G), D764.3 (K_G)
COL_G_09: D9.3 (K_G), D37.3 (K_G), D65.3 (K_G), D93.3 (K_G), D121.3 (K_G), D149.3 (K_G), D177.3 (K_G), D205.3 (K_G), D233.3 (K_G), D261.3 (K_G), D289.3 (K_G), D317.3 (K_G), D345.3 (K_G), D373.3 (K_G), D401.3 (K_G), D429.3 (K_G), D457.3 (K_G), D485.3 (K_G), D513.3 (K_G), D541.3 (K_G), D569.3 (K_G), D597.3 (K_G), D625.3 (K_G), D653.3 (K_G), D681.3 (K_G), D709.3 (K_G), D737.3 (K_G), D765.3 (K_G)
COL_G_10: D10.3 (K_G), D38.3 (K_G), D66.3 (K_G), D94.3 (K_G), D122.3 (K_G), D150.3 (K_G), D178.3 (K_G), D206.3 (K_G), D234.3 (K_G), D262.3 (K_G), D290.3 (K_G), D318.3 (K_G), D346.3 (K_G), D374.3 (K_G), D402.3 (K_G), D430.3 (K_G), D458.3 (K_G), D486.3 (K_G), D514.3 (K_G), D542.3 (K_G), D570.3 (K_G), D598.3 (K_G), D626.3 (K_G), D654.3 (K_G), D682.3 (K_G), D710.3 (K_G), D738.3 (K_G), D766.3 (K_G)
COL_G_11: D11.3 (K_G), D39.3 (K_G), D67.3 (K_G), D95.3 (K_G), D123.3 (K_G), D151.3 (K_G), D179.3 (K_G), D207.3 (K_G), D235.3 (K_G), D263.3 (K_G), D291.3 (K_G), D319.3 (K_G), D347.3 (K_G), D375.3 (K_G), D403.3 (K_G), D431.3 (K_G), D459.3 (K_G), D487.3 (K_G), D515.3 (K_G), D543.3 (K_G), D571.3 (K_G), D599.3 (K_G), D627.3 (K_G), D655.3 (K_G), D683.3 (K_G), D711.3 (K_G), D739.3 (K_G), D767.3 (K_G)
COL_G_12: D12.3 (K_G), D40.3 (K_G), D68.3 (K_G), D96.3 (K_G), D124.3 (K_G), D152.3 (K_G), D180.3 (K_G), D208.3 (K_G), D236.3 (K_G), D264.3 (K_G), D292.3 (K_G), D320.3 (K_G), D348.3 (K_G), D376.3 (K_G), D404.3 (K_G), D432.3 (K_G), D460.3 (K_G), D488.3 (K_G), D516.3 (K_G), D544.3 (K_G), D572.3 (K_G), D600.3 (K_G), D628.3 (K_G), D656.3 (K_G), D684.3 (K_G), D712.3 (K_G), D740.3 (K_G), D768.3 (K_G)
COL_G_13: D13.3 (K_G), D41.3 (K_G), D69.3 (K_G), D97.3 (K_G), D125.3 (K_G), D153.3 (K_G), D181.3 (K_G), D209.3 (K_G), D237.3 (K_G), D265.3 (K_G), D293.3 (K_G), D321.3 (K_G), D349.3 (K_G), D377.3 (K_G), D405.3 (K_G), D433.3 (K_G), D461.3 (K_G), D489.3 (K_G), D517.3 (K_G), D545.3 (K_G), D573.3 (K_G), D601.3 (K_G), D629.3 (K_G), D657.3 (K_G), D685.3 (K_G), D713.3 (K_G), D741.3 (K_G), D769.3 (K_G)
COL_G_14: D14.3 (K_G), D42.3 (K_G), D70.3 (K_G), D98.3 (K_G), D126.3 (K_G), D154.3 (K_G), D182.3 (K_G), D210.3 (K_G), D238.3 (K_G), D266.3 (K_G), D294.3 (K_G), D322.3 (K_G), D350.3 (K_G), D378.3 (K_G), D406.3 (K_G), D434.3 (K_G), D462.3 (K_G), D490.3 (K_G), D518.3 (K_G), D546.3 (K_G), D574.3 (K_G), D602.3 (K_G), D630.3 (K_G), D658.3 (K_G), D686.3 (K_G), D714.3 (K_G), D742.3 (K_G), D770.3 (K_G)
COL_G_15: D15.3 (K_G), D43.3 (K_G), D71.3 (K_G), D99.3 (K_G), D127.3 (K_G), D155.3 (K_G), D183.3 (K_G), D211.3 (K_G), D239.3 (K_G), D267.3 (K_G), D295.3 (K_G), D323.3 (K_G), D351.3 (K_G), D379.3 (K_G), D407.3 (K_G), D435.3 (K_G), D463.3 (K_G), D491.3 (K_G), D519.3 (K_G), D547.3 (K_G), D575.3 (K_G), D603.3 (K_G), D631.3 (K_G), D659.3 (K_G), D687.3 (K_G), D715.3 (K_G), D743.3 (K_G), D771.3 (K_G)
COL_G_16: D16.3 (K_G), D44.3 (K_G), D72.3 (K_G), D100.3 (K_G), D128.3 (K_G), D156.3 (K_G), D184.3 (K_G), D212.3 (K_G), D240.3 (K_G), D268.3 (K_G), D296.3 (K_G), D324.3 (K_G), D352.3 (K_G), D380.3 (K_G), D408.3 (K_G), D436.3 (K_G), D464.3 (K_G), D492.3 (K_G), D520.3 (K_G), D548.3 (K_G), D576.3 (K_G), D604.3 (K_G), D632.3 (K_G), D660.3 (K_G), D688.3 (K_G), D716.3 (K_G), D744.3 (K_G), D772.3 (K_G)
COL_G_17: D17.3 (K_G), D45.3 (K_G), D73.3 (K_G), D101.3 (K_G), D129.3 (K_G), D157.3 (K_G), D185.3 (K_G), D213.3 (K_G), D241.3 (K_G), D269.3 (K_G), D297.3 (K_G), D325.3 (K_G), D353.3 (K_G), D381.3 (K_G), D409.3 (K_G), D437.3 (K_G), D465.3 (K_G), D493.3 (K_G), D521.3 (K_G), D549.3 (K_G), D577.3 (K_G), D605.3 (K_G), D633.3 (K_G), D661.3 (K_G), D689.3 (K_G), D717.3 (K_G), D745.3 (K_G), D773.3 (K_G)
COL_G_18: D18.3 (K_G), D46.3 (K_G), D74.3 (K_G), D102.3 (K_G), D130.3 (K_G), D158.3 (K_G), D186.3 (K_G), D214.3 (K_G), D242.3 (K_G), D270.3 (K_G), D298.3 (K_G), D326.3 (K_G), D354.3 (K_G), D382.3 (K_G), D410.3 (K_G), D438.3 (K_G), D466.3 (K_G), D494.3 (K_G), D522.3 (K_G), D550.3 (K_G), D578.3 (K_G), D606.3 (K_G), D634.3 (K_G), D662.3 (K_G), D690.3 (K_G), D718.3 (K_G), D746.3 (K_G), D774.3 (K_G)
COL_G_19: D19.3 (K_G), D47.3 (K_G), D75.3 (K_G), D103.3 (K_G), D131.3 (K_G), D159.3 (K_G), D187.3 (K_G), D215.3 (K_G), D243.3 (K_G), D271.3 (K_G), D299.3 (K_G), D327.3 (K_G), D355.3 (K_G), D383.3 (K_G), D411.3 (K_G), D439.3 (K_G), D467.3 (K_G), D495.3 (K_G), D523.3 (K_G), D551.3 (K_G), D579.3 (K_G), D607.3 (K_G), D635.3 (K_G), D663.3 (K_G), D691.3 (K_G), D719.3 (K_G), D747.3 (K_G), D775.3 (K_G)
COL_G_20: D20.3 (K_G), D48.3 (K_G), D76.3 (K_G), D104.3 (K_G), D132.3 (K_G), D160.3 (K_G), D188.3 (K_G), D216.3 (K_G), D244.3 (K_G), D272.3 (K_G), D300.3 (K_G), D328.3 (K_G), D356.3 (K_G), D384.3 (K_G), D412.3 (K_G), D440.3 (K_G), D468.3 (K_G), D496.3 (K_G), D524.3 (K_G), D552.3 (K_G), D580.3 (K_G), D608.3 (K_G), D636.3 (K_G), D664.3 (K_G), D692.3 (K_G), D720.3 (K_G), D748.3 (K_G), D776.3 (K_G)
COL_G_21: D21.3 (K_G), D49.3 (K_G), D77.3 (K_G), D105.3 (K_G), D133.3 (K_G), D161.3 (K_G), D189.3 (K_G), D217.3 (K_G), D245.3 (K_G), D273.3 (K_G), D301.3 (K_G), D329.3 (K_G), D357.3 (K_G), D385.3 (K_G), D413.3 (K_G), D441.3 (K_G), D469.3 (K_G), D497.3 (K_G), D525.3 (K_G), D553.3 (K_G), D581.3 (K_G), D609.3 (K_G), D637.3 (K_G), D665.3 (K_G), D693.3 (K_G), D721.3 (K_G), D749.3 (K_G), D777.3 (K_G)
COL_G_22: D22.3 (K_G), D50.3 (K_G), D78.3 (K_G), D106.3 (K_G), D134.3 (K_G), D162.3 (K_G), D190.3 (K_G), D218.3 (K_G), D246.3 (K_G), D274.3 (K_G), D302.3 (K_G), D330.3 (K_G), D358.3 (K_G), D386.3 (K_G), D414.3 (K_G), D442.3 (K_G), D470.3 (K_G), D498.3 (K_G), D526.3 (K_G), D554.3 (K_G), D582.3 (K_G), D610.3 (K_G), D638.3 (K_G), D666.3 (K_G), D694.3 (K_G), D722.3 (K_G), D750.3 (K_G), D778.3 (K_G)
COL_G_23: D23.3 (K_G), D51.3 (K_G), D79.3 (K_G), D107.3 (K_G), D135.3 (K_G), D163.3 (K_G), D191.3 (K_G), D219.3 (K_G), D247.3 (K_G), D275.3 (K_G), D303.3 (K_G), D331.3 (K_G), D359.3 (K_G), D387.3 (K_G), D415.3 (K_G), D443.3 (K_G), D471.3 (K_G), D499.3 (K_G), D527.3 (K_G), D555.3 (K_G), D583.3 (K_G), D611.3 (K_G), D639.3 (K_G), D667.3 (K_G), D695.3 (K_G), D723.3 (K_G), D751.3 (K_G), D779.3 (K_G)
COL_G_24: D24.3 (K_G), D52.3 (K_G), D80.3 (K_G), D108.3 (K_G), D136.3 (K_G), D164.3 (K_G), D192.3 (K_G), D220.3 (K_G), D248.3 (K_G), D276.3 (K_G), D304.3 (K_G), D332.3 (K_G), D360.3 (K_G), D388.3 (K_G), D416.3 (K_G), D444.3 (K_G), D472.3 (K_G), D500.3 (K_G), D528.3 (K_G), D556.3 (K_G), D584.3 (K_G), D612.3 (K_G), D640.3 (K_G), D668.3 (K_G), D696.3 (K_G), D724.3 (K_G), D752.3 (K_G), D780.3 (K_G)
COL_G_25: D25.3 (K_G), D53.3 (K_G), D81.3 (K_G), D109.3 (K_G), D137.3 (K_G), D165.3 (K_G), D193.3 (K_G), D221.3 (K_G), D249.3 (K_G), D277.3 (K_G), D305.3 (K_G), D333.3 (K_G), D361.3 (K_G), D389.3 (K_G), D417.3 (K_G), D445.3 (K_G), D473.3 (K_G), D501.3 (K_G), D529.3 (K_G), D557.3 (K_G), D585.3 (K_G), D613.3 (K_G), D641.3 (K_G), D669.3 (K_G), D697.3 (K_G), D725.3 (K_G), D753.3 (K_G), D781.3 (K_G)
COL_G_26: D26.3 (K_G), D54.3 (K_G), D82.3 (K_G), D110.3 (K_G), D138.3 (K_G), D166.3 (K_G), D194.3 (K_G), D222.3 (K_G), D250.3 (K_G), D278.3 (K_G), D306.3 (K_G), D334.3 (K_G), D362.3 (K_G), D390.3 (K_G), D418.3 (K_G), D446.3 (K_G), D474.3 (K_G), D502.3 (K_G), D530.3 (K_G), D558.3 (K_G), D586.3 (K_G), D614.3 (K_G), D642.3 (K_G), D670.3 (K_G), D698.3 (K_G), D726.3 (K_G), D754.3 (K_G), D782.3 (K_G)
COL_G_27: D27.3 (K_G), D55.3 (K_G), D83.3 (K_G), D111.3 (K_G), D139.3 (K_G), D167.3 (K_G), D195.3 (K_G), D223.3 (K_G), D251.3 (K_G), D279.3 (K_G), D307.3 (K_G), D335.3 (K_G), D363.3 (K_G), D391.3 (K_G), D419.3 (K_G), D447.3 (K_G), D475.3 (K_G), D503.3 (K_G), D531.3 (K_G), D559.3 (K_G), D587.3 (K_G), D615.3 (K_G), D643.3 (K_G), D671.3 (K_G), D699.3 (K_G), D727.3 (K_G), D755.3 (K_G), D783.3 (K_G)
COL_G_28: D28.3 (K_G), D56.3 (K_G), D84.3 (K_G), D112.3 (K_G), D140.3 (K_G), D168.3 (K_G), D196.3 (K_G), D224.3 (K_G), D252.3 (K_G), D280.3 (K_G), D308.3 (K_G), D336.3 (K_G), D364.3 (K_G), D392.3 (K_G), D420.3 (K_G), D448.3 (K_G), D476.3 (K_G), D504.3 (K_G), D532.3 (K_G), D560.3 (K_G), D588.3 (K_G), D616.3 (K_G), D644.3 (K_G), D672.3 (K_G), D700.3 (K_G), D728.3 (K_G), D756.3 (K_G), D784.3 (K_G)
COL_R_01: D1.2 (K_R), D29.2 (K_R), D57.2 (K_R), D85.2 (K_R), D113.2 (K_R), D141.2 (K_R), D169.2 (K_R), D197.2 (K_R), D225.2 (K_R), D253.2 (K_R), D281.2 (K_R), D309.2 (K_R), D337.2 (K_R), D365.2 (K_R), D393.2 (K_R), D421.2 (K_R), D449.2 (K_R), D477.2 (K_R), D505.2 (K_R), D533.2 (K_R), D561.2 (K_R), D589.2 (K_R), D617.2 (K_R), D645.2 (K_R), D673.2 (K_R), D701.2 (K_R), D729.2 (K_R), D757.2 (K_R)
COL_R_02: D2.2 (K_R), D30.2 (K_R), D58.2 (K_R), D86.2 (K_R), D114.2 (K_R), D142.2 (K_R), D170.2 (K_R), D198.2 (K_R), D226.2 (K_R), D254.2 (K_R), D282.2 (K_R), D310.2 (K_R), D338.2 (K_R), D366.2 (K_R), D394.2 (K_R), D422.2 (K_R), D450.2 (K_R), D478.2 (K_R), D506.2 (K_R), D534.2 (K_R), D562.2 (K_R), D590.2 (K_R), D618.2 (K_R), D646.2 (K_R), D674.2 (K_R), D702.2 (K_R), D730.2 (K_R), D758.2 (K_R)
COL_R_03: D3.2 (K_R), D31.2 (K_R), D59.2 (K_R), D87.2 (K_R), D115.2 (K_R), D143.2 (K_R), D171.2 (K_R), D199.2 (K_R), D227.2 (K_R), D255.2 (K_R), D283.2 (K_R), D311.2 (K_R), D339.2 (K_R), D367.2 (K_R), D395.2 (K_R), D423.2 (K_R), D451.2 (K_R), D479.2 (K_R), D507.2 (K_R), D535.2 (K_R), D563.2 (K_R), D591.2 (K_R), D619.2 (K_R), D647.2 (K_R), D675.2 (K_R), D703.2 (K_R), D731.2 (K_R), D759.2 (K_R)
COL_R_04: D4.2 (K_R), D32.2 (K_R), D60.2 (K_R), D88.2 (K_R), D116.2 (K_R), D144.2 (K_R), D172.2 (K_R), D200.2 (K_R), D228.2 (K_R), D256.2 (K_R), D284.2 (K_R), D312.2 (K_R), D340.2 (K_R), D368.2 (K_R), D396.2 (K_R), D424.2 (K_R), D452.2 (K_R), D480.2 (K_R), D508.2 (K_R), D536.2 (K_R), D564.2 (K_R), D592.2 (K_R), D620.2 (K_R), D648.2 (K_R), D676.2 (K_R), D704.2 (K_R), D732.2 (K_R), D760.2 (K_R)
COL_R_05: D5.2 (K_R), D33.2 (K_R), D61.2 (K_R), D89.2 (K_R), D117.2 (K_R), D145.2 (K_R), D173.2 (K_R), D201.2 (K_R), D229.2 (K_R), D257.2 (K_R), D285.2 (K_R), D313.2 (K_R), D341.2 (K_R), D369.2 (K_R), D397.2 (K_R), D425.2 (K_R), D453.2 (K_R), D481.2 (K_R), D509.2 (K_R), D537.2 (K_R), D565.2 (K_R), D593.2 (K_R), D621.2 (K_R), D649.2 (K_R), D677.2 (K_R), D705.2 (K_R), D733.2 (K_R), D761.2 (K_R)
COL_R_06: D6.2 (K_R), D34.2 (K_R), D62.2 (K_R), D90.2 (K_R), D118.2 (K_R), D146.2 (K_R), D174.2 (K_R), D202.2 (K_R), D230.2 (K_R), D258.2 (K_R), D286.2 (K_R), D314.2 (K_R), D342.2 (K_R), D370.2 (K_R), D398.2 (K_R), D426.2 (K_R), D454.2 (K_R), D482.2 (K_R), D510.2 (K_R), D538.2 (K_R), D566.2 (K_R), D594.2 (K_R), D622.2 (K_R), D650.2 (K_R), D678.2 (K_R), D706.2 (K_R), D734.2 (K_R), D762.2 (K_R)
COL_R_07: D7.2 (K_R), D35.2 (K_R), D63.2 (K_R), D91.2 (K_R), D119.2 (K_R), D147.2 (K_R), D175.2 (K_R), D203.2 (K_R), D231.2 (K_R), D259.2 (K_R), D287.2 (K_R), D315.2 (K_R), D343.2 (K_R), D371.2 (K_R), D399.2 (K_R), D427.2 (K_R), D455.2 (K_R), D483.2 (K_R), D511.2 (K_R), D539.2 (K_R), D567.2 (K_R), D595.2 (K_R), D623.2 (K_R), D651.2 (K_R), D679.2 (K_R), D707.2 (K_R), D735.2 (K_R), D763.2 (K_R)
COL_R_08: D8.2 (K_R), D36.2 (K_R), D64.2 (K_R), D92.2 (K_R), D120.2 (K_R), D148.2 (K_R), D176.2 (K_R), D204.2 (K_R), D232.2 (K_R), D260.2 (K_R), D288.2 (K_R), D316.2 (K_R), D344.2 (K_R), D372.2 (K_R), D400.2 (K_R), D428.2 (K_R), D456.2 (K_R), D484.2 (K_R), D512.2 (K_R), D540.2 (K_R), D568.2 (K_R), D596.2 (K_R), D624.2 (K_R), D652.2 (K_R), D680.2 (K_R), D708.2 (K_R), D736.2 (K_R), D764.2 (K_R)
COL_R_09: D9.2 (K_R), D37.2 (K_R), D65.2 (K_R), D93.2 (K_R), D121.2 (K_R), D149.2 (K_R), D177.2 (K_R), D205.2 (K_R), D233.2 (K_R), D261.2 (K_R), D289.2 (K_R), D317.2 (K_R), D345.2 (K_R), D373.2 (K_R), D401.2 (K_R), D429.2 (K_R), D457.2 (K_R), D485.2 (K_R), D513.2 (K_R), D541.2 (K_R), D569.2 (K_R), D597.2 (K_R), D625.2 (K_R), D653.2 (K_R), D681.2 (K_R), D709.2 (K_R), D737.2 (K_R), D765.2 (K_R)
COL_R_10: D10.2 (K_R), D38.2 (K_R), D66.2 (K_R), D94.2 (K_R), D122.2 (K_R), D150.2 (K_R), D178.2 (K_R), D206.2 (K_R), D234.2 (K_R), D262.2 (K_R), D290.2 (K_R), D318.2 (K_R), D346.2 (K_R), D374.2 (K_R), D402.2 (K_R), D430.2 (K_R), D458.2 (K_R), D486.2 (K_R), D514.2 (K_R), D542.2 (K_R), D570.2 (K_R), D598.2 (K_R), D626.2 (K_R), D654.2 (K_R), D682.2 (K_R), D710.2 (K_R), D738.2 (K_R), D766.2 (K_R)
COL_R_11: D11.2 (K_R), D39.2 (K_R), D67.2 (K_R), D95.2 (K_R), D123.2 (K_R), D151.2 (K_R), D179.2 (K_R), D207.2 (K_R), D235.2 (K_R), D263.2 (K_R), D291.2 (K_R), D319.2 (K_R), D347.2 (K_R), D375.2 (K_R), D403.2 (K_R), D431.2 (K_R), D459.2 (K_R), D487.2 (K_R), D515.2 (K_R), D543.2 (K_R), D571.2 (K_R), D599.2 (K_R), D627.2 (K_R), D655.2 (K_R), D683.2 (K_R), D711.2 (K_R), D739.2 (K_R), D767.2 (K_R)
COL_R_12: D12.2 (K_R), D40.2 (K_R), D68.2 (K_R), D96.2 (K_R), D124.2 (K_R), D152.2 (K_R), D180.2 (K_R), D208.2 (K_R), D236.2 (K_R), D264.2 (K_R), D292.2 (K_R), D320.2 (K_R), D348.2 (K_R), D376.2 (K_R), D404.2 (K_R), D432.2 (K_R), D460.2 (K_R), D488.2 (K_R), D516.2 (K_R), D544.2 (K_R), D572.2 (K_R), D600.2 (K_R), D628.2 (K_R), D656.2 (K_R), D684.2 (K_R), D712.2 (K_R), D740.2 (K_R), D768.2 (K_R)
COL_R_13: D13.2 (K_R), D41.2 (K_R), D69.2 (K_R), D97.2 (K_R), D125.2 (K_R), D153.2 (K_R), D181.2 (K_R), D209.2 (K_R), D237.2 (K_R), D265.2 (K_R), D293.2 (K_R), D321.2 (K_R), D349.2 (K_R), D377.2 (K_R), D405.2 (K_R), D433.2 (K_R), D461.2 (K_R), D489.2 (K_R), D517.2 (K_R), D545.2 (K_R), D573.2 (K_R), D601.2 (K_R), D629.2 (K_R), D657.2 (K_R), D685.2 (K_R), D713.2 (K_R), D741.2 (K_R), D769.2 (K_R)
COL_R_14: D14.2 (K_R), D42.2 (K_R), D70.2 (K_R), D98.2 (K_R), D126.2 (K_R), D154.2 (K_R), D182.2 (K_R), D210.2 (K_R), D238.2 (K_R), D266.2 (K_R), D294.2 (K_R), D322.2 (K_R), D350.2 (K_R), D378.2 (K_R), D406.2 (K_R), D434.2 (K_R), D462.2 (K_R), D490.2 (K_R), D518.2 (K_R), D546.2 (K_R), D574.2 (K_R), D602.2 (K_R), D630.2 (K_R), D658.2 (K_R), D686.2 (K_R), D714.2 (K_R), D742.2 (K_R), D770.2 (K_R)
COL_R_15: D15.2 (K_R), D43.2 (K_R), D71.2 (K_R), D99.2 (K_R), D127.2 (K_R), D155.2 (K_R), D183.2 (K_R), D211.2 (K_R), D239.2 (K_R), D267.2 (K_R), D295.2 (K_R), D323.2 (K_R), D351.2 (K_R), D379.2 (K_R), D407.2 (K_R), D435.2 (K_R), D463.2 (K_R), D491.2 (K_R), D519.2 (K_R), D547.2 (K_R), D575.2 (K_R), D603.2 (K_R), D631.2 (K_R), D659.2 (K_R), D687.2 (K_R), D715.2 (K_R), D743.2 (K_R), D771.2 (K_R)
COL_R_16: D16.2 (K_R), D44.2 (K_R), D72.2 (K_R), D100.2 (K_R), D128.2 (K_R), D156.2 (K_R), D184.2 (K_R), D212.2 (K_R), D240.2 (K_R), D268.2 (K_R), D296.2 (K_R), D324.2 (K_R), D352.2 (K_R), D380.2 (K_R), D408.2 (K_R), D436.2 (K_R), D464.2 (K_R), D492.2 (K_R), D520.2 (K_R), D548.2 (K_R), D576.2 (K_R), D604.2 (K_R), D632.2 (K_R), D660.2 (K_R), D688.2 (K_R), D716.2 (K_R), D744.2 (K_R), D772.2 (K_R)
COL_R_17: D17.2 (K_R), D45.2 (K_R), D73.2 (K_R), D101.2 (K_R), D129.2 (K_R), D157.2 (K_R), D185.2 (K_R), D213.2 (K_R), D241.2 (K_R), D269.2 (K_R), D297.2 (K_R), D325.2 (K_R), D353.2 (K_R), D381.2 (K_R), D409.2 (K_R), D437.2 (K_R), D465.2 (K_R), D493.2 (K_R), D521.2 (K_R), D549.2 (K_R), D577.2 (K_R), D605.2 (K_R), D633.2 (K_R), D661.2 (K_R), D689.2 (K_R), D717.2 (K_R), D745.2 (K_R), D773.2 (K_R)
COL_R_18: D18.2 (K_R), D46.2 (K_R), D74.2 (K_R), D102.2 (K_R), D130.2 (K_R), D158.2 (K_R), D186.2 (K_R), D214.2 (K_R), D242.2 (K_R), D270.2 (K_R), D298.2 (K_R), D326.2 (K_R), D354.2 (K_R), D382.2 (K_R), D410.2 (K_R), D438.2 (K_R), D466.2 (K_R), D494.2 (K_R), D522.2 (K_R), D550.2 (K_R), D578.2 (K_R), D606.2 (K_R), D634.2 (K_R), D662.2 (K_R), D690.2 (K_R), D718.2 (K_R), D746.2 (K_R), D774.2 (K_R)
COL_R_19: D19.2 (K_R), D47.2 (K_R), D75.2 (K_R), D103.2 (K_R), D131.2 (K_R), D159.2 (K_R), D187.2 (K_R), D215.2 (K_R), D243.2 (K_R), D271.2 (K_R), D299.2 (K_R), D327.2 (K_R), D355.2 (K_R), D383.2 (K_R), D411.2 (K_R), D439.2 (K_R), D467.2 (K_R), D495.2 (K_R), D523.2 (K_R), D551.2 (K_R), D579.2 (K_R), D607.2 (K_R), D635.2 (K_R), D663.2 (K_R), D691.2 (K_R), D719.2 (K_R), D747.2 (K_R), D775.2 (K_R)
COL_R_20: D20.2 (K_R), D48.2 (K_R), D76.2 (K_R), D104.2 (K_R), D132.2 (K_R), D160.2 (K_R), D188.2 (K_R), D216.2 (K_R), D244.2 (K_R), D272.2 (K_R), D300.2 (K_R), D328.2 (K_R), D356.2 (K_R), D384.2 (K_R), D412.2 (K_R), D440.2 (K_R), D468.2 (K_R), D496.2 (K_R), D524.2 (K_R), D552.2 (K_R), D580.2 (K_R), D608.2 (K_R), D636.2 (K_R), D664.2 (K_R), D692.2 (K_R), D720.2 (K_R), D748.2 (K_R), D776.2 (K_R)
COL_R_21: D21.2 (K_R), D49.2 (K_R), D77.2 (K_R), D105.2 (K_R), D133.2 (K_R), D161.2 (K_R), D189.2 (K_R), D217.2 (K_R), D245.2 (K_R), D273.2 (K_R), D301.2 (K_R), D329.2 (K_R), D357.2 (K_R), D385.2 (K_R), D413.2 (K_R), D441.2 (K_R), D469.2 (K_R), D497.2 (K_R), D525.2 (K_R), D553.2 (K_R), D581.2 (K_R), D609.2 (K_R), D637.2 (K_R), D665.2 (K_R), D693.2 (K_R), D721.2 (K_R), D749.2 (K_R), D777.2 (K_R)
COL_R_22: D22.2 (K_R), D50.2 (K_R), D78.2 (K_R), D106.2 (K_R), D134.2 (K_R), D162.2 (K_R), D190.2 (K_R), D218.2 (K_R), D246.2 (K_R), D274.2 (K_R), D302.2 (K_R), D330.2 (K_R), D358.2 (K_R), D386.2 (K_R), D414.2 (K_R), D442.2 (K_R), D470.2 (K_R), D498.2 (K_R), D526.2 (K_R), D554.2 (K_R), D582.2 (K_R), D610.2 (K_R), D638.2 (K_R), D666.2 (K_R), D694.2 (K_R), D722.2 (K_R), D750.2 (K_R), D778.2 (K_R)
COL_R_23: D23.2 (K_R), D51.2 (K_R), D79.2 (K_R), D107.2 (K_R), D135.2 (K_R), D163.2 (K_R), D191.2 (K_R), D219.2 (K_R), D247.2 (K_R), D275.2 (K_R), D303.2 (K_R), D331.2 (K_R), D359.2 (K_R), D387.2 (K_R), D415.2 (K_R), D443.2 (K_R), D471.2 (K_R), D499.2 (K_R), D527.2 (K_R), D555.2 (K_R), D583.2 (K_R), D611.2 (K_R), D639.2 (K_R), D667.2 (K_R), D695.2 (K_R), D723.2 (K_R), D751.2 (K_R), D779.2 (K_R)
COL_R_24: D24.2 (K_R), D52.2 (K_R), D80.2 (K_R), D108.2 (K_R), D136.2 (K_R), D164.2 (K_R), D192.2 (K_R), D220.2 (K_R), D248.2 (K_R), D276.2 (K_R), D304.2 (K_R), D332.2 (K_R), D360.2 (K_R), D388.2 (K_R), D416.2 (K_R), D444.2 (K_R), D472.2 (K_R), D500.2 (K_R), D528.2 (K_R), D556.2 (K_R), D584.2 (K_R), D612.2 (K_R), D640.2 (K_R), D668.2 (K_R), D696.2 (K_R), D724.2 (K_R), D752.2 (K_R), D780.2 (K_R)
COL_R_25: D25.2 (K_R), D53.2 (K_R), D81.2 (K_R), D109.2 (K_R), D137.2 (K_R), D165.2 (K_R), D193.2 (K_R), D221.2 (K_R), D249.2 (K_R), D277.2 (K_R), D305.2 (K_R), D333.2 (K_R), D361.2 (K_R), D389.2 (K_R), D417.2 (K_R), D445.2 (K_R), D473.2 (K_R), D501.2 (K_R), D529.2 (K_R), D557.2 (K_R), D585.2 (K_R), D613.2 (K_R), D641.2 (K_R), D669.2 (K_R), D697.2 (K_R), D725.2 (K_R), D753.2 (K_R), D781.2 (K_R)
COL_R_26: D26.2 (K_R), D54.2 (K_R), D82.2 (K_R), D110.2 (K_R), D138.2 (K_R), D166.2 (K_R), D194.2 (K_R), D222.2 (K_R), D250.2 (K_R), D278.2 (K_R), D306.2 (K_R), D334.2 (K_R), D362.2 (K_R), D390.2 (K_R), D418.2 (K_R), D446.2 (K_R), D474.2 (K_R), D502.2 (K_R), D530.2 (K_R), D558.2 (K_R), D586.2 (K_R), D614.2 (K_R), D642.2 (K_R), D670.2 (K_R), D698.2 (K_R), D726.2 (K_R), D754.2 (K_R), D782.2 (K_R)
COL_R_27: D27.2 (K_R), D55.2 (K_R), D83.2 (K_R), D111.2 (K_R), D139.2 (K_R), D167.2 (K_R), D195.2 (K_R), D223.2 (K_R), D251.2 (K_R), D279.2 (K_R), D307.2 (K_R), D335.2 (K_R), D363.2 (K_R), D391.2 (K_R), D419.2 (K_R), D447.2 (K_R), D475.2 (K_R), D503.2 (K_R), D531.2 (K_R), D559.2 (K_R), D587.2 (K_R), D615.2 (K_R), D643.2 (K_R), D671.2 (K_R), D699.2 (K_R), D727.2 (K_R), D755.2 (K_R), D783.2 (K_R)
COL_R_28: D28.2 (K_R), D56.2 (K_R), D84.2 (K_R), D112.2 (K_R), D140.2 (K_R), D168.2 (K_R), D196.2 (K_R), D224.2 (K_R), D252.2 (K_R), D280.2 (K_R), D308.2 (K_R), D336.2 (K_R), D364.2 (K_R), D392.2 (K_R), D420.2 (K_R), D448.2 (K_R), D476.2 (K_R), D504.2 (K_R), D532.2 (K_R), D560.2 (K_R), D588.2 (K_R), D616.2 (K_R), D644.2 (K_R), D672.2 (K_R), D700.2 (K_R), D728.2 (K_R), D756.2 (K_R), D784.2 (K_R)
ROW_01_ANODE: D1.1 (A), D2.1 (A), D3.1 (A), D4.1 (A), D5.1 (A), D6.1 (A), D7.1 (A), D8.1 (A), D9.1 (A), D10.1 (A), D11.1 (A), D12.1 (A), D13.1 (A), D14.1 (A), D15.1 (A), D16.1 (A), D17.1 (A), D18.1 (A), D19.1 (A), D20.1 (A), D21.1 (A), D22.1 (A), D23.1 (A), D24.1 (A), D25.1 (A), D26.1 (A), D27.1 (A), D28.1 (A)
ROW_02_ANODE: D29.1 (A), D30.1 (A), D31.1 (A), D32.1 (A), D33.1 (A), D34.1 (A), D35.1 (A), D36.1 (A), D37.1 (A), D38.1 (A), D39.1 (A), D40.1 (A), D41.1 (A), D42.1 (A), D43.1 (A), D44.1 (A), D45.1 (A), D46.1 (A), D47.1 (A), D48.1 (A), D49.1 (A), D50.1 (A), D51.1 (A), D52.1 (A), D53.1 (A), D54.1 (A), D55.1 (A), D56.1 (A)
ROW_03_ANODE: D57.1 (A), D58.1 (A), D59.1 (A), D60.1 (A), D61.1 (A), D62.1 (A), D63.1 (A), D64.1 (A), D65.1 (A), D66.1 (A), D67.1 (A), D68.1 (A), D69.1 (A), D70.1 (A), D71.1 (A), D72.1 (A), D73.1 (A), D74.1 (A), D75.1 (A), D76.1 (A), D77.1 (A), D78.1 (A), D79.1 (A), D80.1 (A), D81.1 (A), D82.1 (A), D83.1 (A), D84.1 (A)
ROW_04_ANODE: D85.1 (A), D86.1 (A), D87.1 (A), D88.1 (A), D89.1 (A), D90.1 (A), D91.1 (A), D92.1 (A), D93.1 (A), D94.1 (A), D95.1 (A), D96.1 (A), D97.1 (A), D98.1 (A), D99.1 (A), D100.1 (A), D101.1 (A), D102.1 (A), D103.1 (A), D104.1 (A), D105.1 (A), D106.1 (A), D107.1 (A), D108.1 (A), D109.1 (A), D110.1 (A), D111.1 (A), D112.1 (A)
ROW_05_ANODE: D113.1 (A), D114.1 (A), D115.1 (A), D116.1 (A), D117.1 (A), D118.1 (A), D119.1 (A), D120.1 (A), D121.1 (A), D122.1 (A), D123.1 (A), D124.1 (A), D125.1 (A), D126.1 (A), D127.1 (A), D128.1 (A), D129.1 (A), D130.1 (A), D131.1 (A), D132.1 (A), D133.1 (A), D134.1 (A), D135.1 (A), D136.1 (A), D137.1 (A), D138.1 (A), D139.1 (A), D140.1 (A)
ROW_06_ANODE: D141.1 (A), D142.1 (A), D143.1 (A), D144.1 (A), D145.1 (A), D146.1 (A), D147.1 (A), D148.1 (A), D149.1 (A), D150.1 (A), D151.1 (A), D152.1 (A), D153.1 (A), D154.1 (A), D155.1 (A), D156.1 (A), D157.1 (A), D158.1 (A), D159.1 (A), D160.1 (A), D161.1 (A), D162.1 (A), D163.1 (A), D164.1 (A), D165.1 (A), D166.1 (A), D167.1 (A), D168.1 (A)
ROW_07_ANODE: D169.1 (A), D170.1 (A), D171.1 (A), D172.1 (A), D173.1 (A), D174.1 (A), D175.1 (A), D176.1 (A), D177.1 (A), D178.1 (A), D179.1 (A), D180.1 (A), D181.1 (A), D182.1 (A), D183.1 (A), D184.1 (A), D185.1 (A), D186.1 (A), D187.1 (A), D188.1 (A), D189.1 (A), D190.1 (A), D191.1 (A), D192.1 (A), D193.1 (A), D194.1 (A), D195.1 (A), D196.1 (A)
ROW_08_ANODE: D197.1 (A), D198.1 (A), D199.1 (A), D200.1 (A), D201.1 (A), D202.1 (A), D203.1 (A), D204.1 (A), D205.1 (A), D206.1 (A), D207.1 (A), D208.1 (A), D209.1 (A), D210.1 (A), D211.1 (A), D212.1 (A), D213.1 (A), D214.1 (A), D215.1 (A), D216.1 (A), D217.1 (A), D218.1 (A), D219.1 (A), D220.1 (A), D221.1 (A), D222.1 (A), D223.1 (A), D224.1 (A)
ROW_09_ANODE: D225.1 (A), D226.1 (A), D227.1 (A), D228.1 (A), D229.1 (A), D230.1 (A), D231.1 (A), D232.1 (A), D233.1 (A), D234.1 (A), D235.1 (A), D236.1 (A), D237.1 (A), D238.1 (A), D239.1 (A), D240.1 (A), D241.1 (A), D242.1 (A), D243.1 (A), D244.1 (A), D245.1 (A), D246.1 (A), D247.1 (A), D248.1 (A), D249.1 (A), D250.1 (A), D251.1 (A), D252.1 (A)
ROW_10_ANODE: D253.1 (A), D254.1 (A), D255.1 (A), D256.1 (A), D257.1 (A), D258.1 (A), D259.1 (A), D260.1 (A), D261.1 (A), D262.1 (A), D263.1 (A), D264.1 (A), D265.1 (A), D266.1 (A), D267.1 (A), D268.1 (A), D269.1 (A), D270.1 (A), D271.1 (A), D272.1 (A), D273.1 (A), D274.1 (A), D275.1 (A), D276.1 (A), D277.1 (A), D278.1 (A), D279.1 (A), D280.1 (A)
ROW_11_ANODE: D281.1 (A), D282.1 (A), D283.1 (A), D284.1 (A), D285.1 (A), D286.1 (A), D287.1 (A), D288.1 (A), D289.1 (A), D290.1 (A), D291.1 (A), D292.1 (A), D293.1 (A), D294.1 (A), D295.1 (A), D296.1 (A), D297.1 (A), D298.1 (A), D299.1 (A), D300.1 (A), D301.1 (A), D302.1 (A), D303.1 (A), D304.1 (A), D305.1 (A), D306.1 (A), D307.1 (A), D308.1 (A)
ROW_12_ANODE: D309.1 (A), D310.1 (A), D311.1 (A), D312.1 (A), D313.1 (A), D314.1 (A), D315.1 (A), D316.1 (A), D317.1 (A), D318.1 (A), D319.1 (A), D320.1 (A), D321.1 (A), D322.1 (A), D323.1 (A), D324.1 (A), D325.1 (A), D326.1 (A), D327.1 (A), D328.1 (A), D329.1 (A), D330.1 (A), D331.1 (A), D332.1 (A), D333.1 (A), D334.1 (A), D335.1 (A), D336.1 (A)
ROW_13_ANODE: D337.1 (A), D338.1 (A), D339.1 (A), D340.1 (A), D341.1 (A), D342.1 (A), D343.1 (A), D344.1 (A), D345.1 (A), D346.1 (A), D347.1 (A), D348.1 (A), D349.1 (A), D350.1 (A), D351.1 (A), D352.1 (A), D353.1 (A), D354.1 (A), D355.1 (A), D356.1 (A), D357.1 (A), D358.1 (A), D359.1 (A), D360.1 (A), D361.1 (A), D362.1 (A), D363.1 (A), D364.1 (A)
ROW_14_ANODE: D365.1 (A), D366.1 (A), D367.1 (A), D368.1 (A), D369.1 (A), D370.1 (A), D371.1 (A), D372.1 (A), D373.1 (A), D374.1 (A), D375.1 (A), D376.1 (A), D377.1 (A), D378.1 (A), D379.1 (A), D380.1 (A), D381.1 (A), D382.1 (A), D383.1 (A), D384.1 (A), D385.1 (A), D386.1 (A), D387.1 (A), D388.1 (A), D389.1 (A), D390.1 (A), D391.1 (A), D392.1 (A)
ROW_15_ANODE: D393.1 (A), D394.1 (A), D395.1 (A), D396.1 (A), D397.1 (A), D398.1 (A), D399.1 (A), D400.1 (A), D401.1 (A), D402.1 (A), D403.1 (A), D404.1 (A), D405.1 (A), D406.1 (A), D407.1 (A), D408.1 (A), D409.1 (A), D410.1 (A), D411.1 (A), D412.1 (A), D413.1 (A), D414.1 (A), D415.1 (A), D416.1 (A), D417.1 (A), D418.1 (A), D419.1 (A), D420.1 (A)
ROW_16_ANODE: D421.1 (A), D422.1 (A), D423.1 (A), D424.1 (A), D425.1 (A), D426.1 (A), D427.1 (A), D428.1 (A), D429.1 (A), D430.1 (A), D431.1 (A), D432.1 (A), D433.1 (A), D434.1 (A), D435.1 (A), D436.1 (A), D437.1 (A), D438.1 (A), D439.1 (A), D440.1 (A), D441.1 (A), D442.1 (A), D443.1 (A), D444.1 (A), D445.1 (A), D446.1 (A), D447.1 (A), D448.1 (A)
ROW_17_ANODE: D449.1 (A), D450.1 (A), D451.1 (A), D452.1 (A), D453.1 (A), D454.1 (A), D455.1 (A), D456.1 (A), D457.1 (A), D458.1 (A), D459.1 (A), D460.1 (A), D461.1 (A), D462.1 (A), D463.1 (A), D464.1 (A), D465.1 (A), D466.1 (A), D467.1 (A), D468.1 (A), D469.1 (A), D470.1 (A), D471.1 (A), D472.1 (A), D473.1 (A), D474.1 (A), D475.1 (A), D476.1 (A)
ROW_18_ANODE: D477.1 (A), D478.1 (A), D479.1 (A), D480.1 (A), D481.1 (A), D482.1 (A), D483.1 (A), D484.1 (A), D485.1 (A), D486.1 (A), D487.1 (A), D488.1 (A), D489.1 (A), D490.1 (A), D491.1 (A), D492.1 (A), D493.1 (A), D494.1 (A), D495.1 (A), D496.1 (A), D497.1 (A), D498.1 (A), D499.1 (A), D500.1 (A), D501.1 (A), D502.1 (A), D503.1 (A), D504.1 (A)
ROW_19_ANODE: D505.1 (A), D506.1 (A), D507.1 (A), D508.1 (A), D509.1 (A), D510.1 (A), D511.1 (A), D512.1 (A), D513.1 (A), D514.1 (A), D515.1 (A), D516.1 (A), D517.1 (A), D518.1 (A), D519.1 (A), D520.1 (A), D521.1 (A), D522.1 (A), D523.1 (A), D524.1 (A), D525.1 (A), D526.1 (A), D527.1 (A), D528.1 (A), D529.1 (A), D530.1 (A), D531.1 (A), D532.1 (A)
ROW_20_ANODE: D533.1 (A), D534.1 (A), D535.1 (A), D536.1 (A), D537.1 (A), D538.1 (A), D539.1 (A), D540.1 (A), D541.1 (A), D542.1 (A), D543.1 (A), D544.1 (A), D545.1 (A), D546.1 (A), D547.1 (A), D548.1 (A), D549.1 (A), D550.1 (A), D551.1 (A), D552.1 (A), D553.1 (A), D554.1 (A), D555.1 (A), D556.1 (A), D557.1 (A), D558.1 (A), D559.1 (A), D560.1 (A)
ROW_21_ANODE: D561.1 (A), D562.1 (A), D563.1 (A), D564.1 (A), D565.1 (A), D566.1 (A), D567.1 (A), D568.1 (A), D569.1 (A), D570.1 (A), D571.1 (A), D572.1 (A), D573.1 (A), D574.1 (A), D575.1 (A), D576.1 (A), D577.1 (A), D578.1 (A), D579.1 (A), D580.1 (A), D581.1 (A), D582.1 (A), D583.1 (A), D584.1 (A), D585.1 (A), D586.1 (A), D587.1 (A), D588.1 (A)
ROW_22_ANODE: D589.1 (A), D590.1 (A), D591.1 (A), D592.1 (A), D593.1 (A), D594.1 (A), D595.1 (A), D596.1 (A), D597.1 (A), D598.1 (A), D599.1 (A), D600.1 (A), D601.1 (A), D602.1 (A), D603.1 (A), D604.1 (A), D605.1 (A), D606.1 (A), D607.1 (A), D608.1 (A), D609.1 (A), D610.1 (A), D611.1 (A), D612.1 (A), D613.1 (A), D614.1 (A), D615.1 (A), D616.1 (A)
ROW_23_ANODE: D617.1 (A), D618.1 (A), D619.1 (A), D620.1 (A), D621.1 (A), D622.1 (A), D623.1 (A), D624.1 (A), D625.1 (A), D626.1 (A), D627.1 (A), D628.1 (A), D629.1 (A), D630.1 (A), D631.1 (A), D632.1 (A), D633.1 (A), D634.1 (A), D635.1 (A), D636.1 (A), D637.1 (A), D638.1 (A), D639.1 (A), D640.1 (A), D641.1 (A), D642.1 (A), D643.1 (A), D644.1 (A)
ROW_24_ANODE: D645.1 (A), D646.1 (A), D647.1 (A), D648.1 (A), D649.1 (A), D650.1 (A), D651.1 (A), D652.1 (A), D653.1 (A), D654.1 (A), D655.1 (A), D656.1 (A), D657.1 (A), D658.1 (A), D659.1 (A), D660.1 (A), D661.1 (A), D662.1 (A), D663.1 (A), D664.1 (A), D665.1 (A), D666.1 (A), D667.1 (A), D668.1 (A), D669.1 (A), D670.1 (A), D671.1 (A), D672.1 (A)
ROW_25_ANODE: D673.1 (A), D674.1 (A), D675.1 (A), D676.1 (A), D677.1 (A), D678.1 (A), D679.1 (A), D680.1 (A), D681.1 (A), D682.1 (A), D683.1 (A), D684.1 (A), D685.1 (A), D686.1 (A), D687.1 (A), D688.1 (A), D689.1 (A), D690.1 (A), D691.1 (A), D692.1 (A), D693.1 (A), D694.1 (A), D695.1 (A), D696.1 (A), D697.1 (A), D698.1 (A), D699.1 (A), D700.1 (A)
ROW_26_ANODE: D701.1 (A), D702.1 (A), D703.1 (A), D704.1 (A), D705.1 (A), D706.1 (A), D707.1 (A), D708.1 (A), D709.1 (A), D710.1 (A), D711.1 (A), D712.1 (A), D713.1 (A), D714.1 (A), D715.1 (A), D716.1 (A), D717.1 (A), D718.1 (A), D719.1 (A), D720.1 (A), D721.1 (A), D722.1 (A), D723.1 (A), D724.1 (A), D725.1 (A), D726.1 (A), D727.1 (A), D728.1 (A)
ROW_27_ANODE: D729.1 (A), D730.1 (A), D731.1 (A), D732.1 (A), D733.1 (A), D734.1 (A), D735.1 (A), D736.1 (A), D737.1 (A), D738.1 (A), D739.1 (A), D740.1 (A), D741.1 (A), D742.1 (A), D743.1 (A), D744.1 (A), D745.1 (A), D746.1 (A), D747.1 (A), D748.1 (A), D749.1 (A), D750.1 (A), D751.1 (A), D752.1 (A), D753.1 (A), D754.1 (A), D755.1 (A), D756.1 (A)
ROW_28_ANODE: D757.1 (A), D758.1 (A), D759.1 (A), D760.1 (A), D761.1 (A), D762.1 (A), D763.1 (A), D764.1 (A), D765.1 (A), D766.1 (A), D767.1 (A), D768.1 (A), D769.1 (A), D770.1 (A), D771.1 (A), D772.1 (A), D773.1 (A), D774.1 (A), D775.1 (A), D776.1 (A), D777.1 (A), D778.1 (A), D779.1 (A), D780.1 (A), D781.1 (A), D782.1 (A), D783.1 (A), D784.1 (A)
