illiapliukhin/leds/hardware/analysis/wearable_20x20_top_right_column_boundary_routing_probe.kicad_pcb

## KiCad design hardware/analysis/wearable_20x20_top_right_column_boundary_routing_probe.kicad_pcb (2026-10-08)

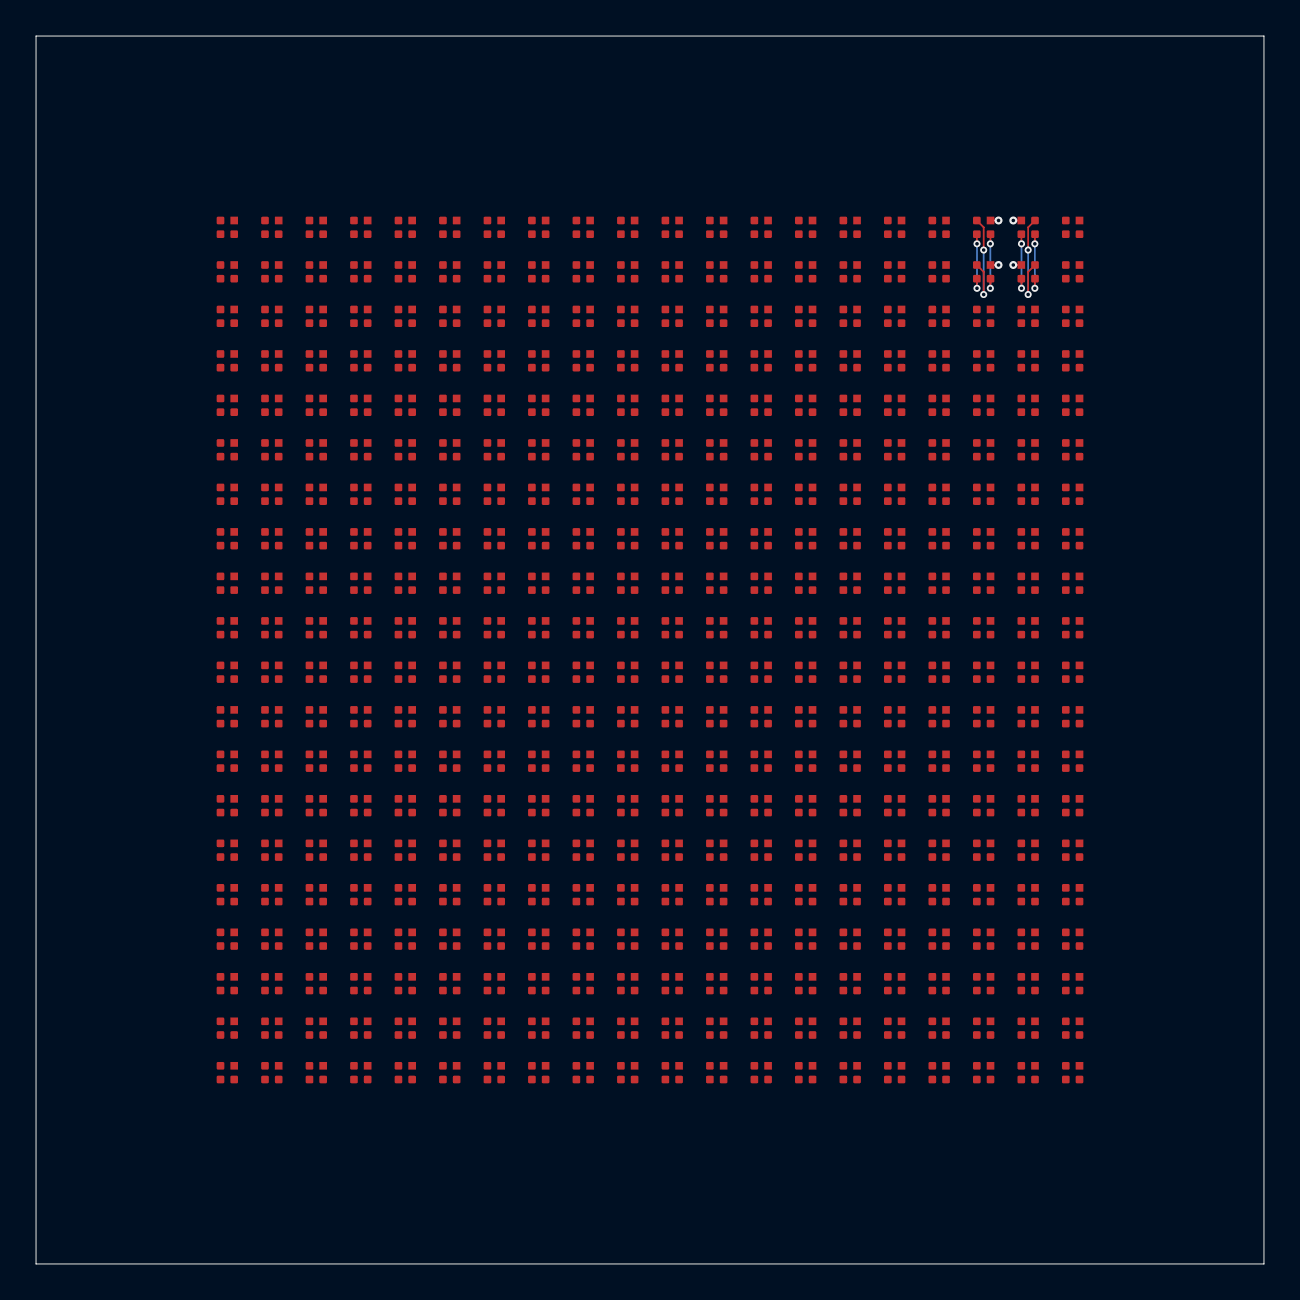
[picture p4: board wearable_20x20_top_right_column_boundary_routing_probe.kicad_pcb from above]

Board: 4 copper layers, 69.0 x 69.0 mm, 400 parts (0 on the bottom side), 80 nets.

Parts:
D1, D2, D3, D4, D5, D6, D7, D8, D9, D10, D11, D12, D13, D14, D15, D16, D17, D18, D19, D20, D21, D22, D23, D24, D25, D26, D27, D28, D29, D30, D31, D32, D33, D34, D35, D36, D37, D38, D39, D40, D41, D42, D43, D44, D45, D46, D47, D48, D49, D50, D51, D52, D53, D54, D55, D56, D57, D58, D59, D60, D61, D62, D63, D64, D65, D66, D67, D68, D69, D70, D71, D72, D73, D74, D75, D76, D77, D78, D79, D80, D81, D82, D83, D84, D85, D86, D87, D88, D89, D90, D91, D92, D93, D94, D95, D96, D97, D98, D99, D100, D101, D102, D103, D104, D105, D106, D107, D108, D109, D110, D111, D112, D113, D114, D115, D116, D117, D118, D119, D120, D121, D122, D123, D124, D125, D126, D127, D128, D129, D130, D131, D132, D133, D134, D135, D136, D137, D138, D139, D140, D141, D142, D143, D144, D145, D146, D147, D148, D149, D150, D151, D152, D153, D154, D155, D156, D157, D158, D159, D160, D161, D162, D163, D164, D165, D166, D167, D168, D169, D170, D171, D172, D173, D174, D175, D176, D177, D178, D179, D180, D181, D182, D183, D184, D185, D186, D187, D188, D189, D190, D191, D192, D193, D194, D195, D196, D197, D198, D199, D200, D201, D202, D203, D204, D205, D206, D207, D208, D209, D210, D211, D212, D213, D214, D215, D216, D217, D218, D219, D220, D221, D222, D223, D224, D225, D226, D227, D228, D229, D230, D231, D232, D233, D234, D235, D236, D237, D238, D239, D240, D241, D242, D243, D244, D245, D246, D247, D248, D249, D250, D251, D252, D253, D254, D255, D256, D257, D258, D259, D260, D261, D262, D263, D264, D265, D266, D267, D268, D269, D270, D271, D272, D273, D274, D275, D276, D277, D278, D279, D280, D281, D282, D283, D284, D285, D286, D287, D288, D289, D290, D291, D292, D293, D294, D295, D296, D297, D298, D299, D300, D301, D302, D303, D304, D305, D306, D307, D308, D309, D310, D311, D312, D313, D314, D315, D316, D317, D318, D319, D320, D321, D322, D323, D324, D325, D326, D327, D328, D329, D330, D331, D332, D333, D334, D335, D336, D337, D338, D339, D340, D341, D342, D343, D344, D345, D346, D347, D348, D349, D350, D351, D352, D353, D354, D355, D356, D357, D358, D359, D360, D361, D362, D363, D364, D365, D366, D367, D368, D369, D370, D371, D372, D373, D374, D375, D376, D377, D378, D379, D380, D381, D382, D383, D384, D385, D386, D387, D388, D389, D390, D391, D392, D393, D394, D395, D396, D397, D398, D399, D400: MHPA1010RGBDT

Connections:
COL_B_01: D1.4 (K_B), D21.4 (K_B), D41.4 (K_B), D61.4 (K_B), D81.4 (K_B), D101.4 (K_B), D121.4 (K_B), D141.4 (K_B), D161.4 (K_B), D181.4 (K_B), D201.4 (K_B), D221.4 (K_B), D241.4 (K_B), D261.4 (K_B), D281.4 (K_B), D301.4 (K_B), D321.4 (K_B), D341.4 (K_B), D361.4 (K_B), D381.4 (K_B)
COL_B_02: D2.4 (K_B), D22.4 (K_B), D42.4 (K_B), D62.4 (K_B), D82.4 (K_B), D102.4 (K_B), D122.4 (K_B), D142.4 (K_B), D162.4 (K_B), D182.4 (K_B), D202.4 (K_B), D222.4 (K_B), D242.4 (K_B), D262.4 (K_B), D282.4 (K_B), D302.4 (K_B), D322.4 (K_B), D342.4 (K_B), D362.4 (K_B), D382.4 (K_B)
COL_B_03: D3.4 (K_B), D23.4 (K_B), D43.4 (K_B), D63.4 (K_B), D83.4 (K_B), D103.4 (K_B), D123.4 (K_B), D143.4 (K_B), D163.4 (K_B), D183.4 (K_B), D203.4 (K_B), D223.4 (K_B), D243.4 (K_B), D263.4 (K_B), D283.4 (K_B), D303.4 (K_B), D323.4 (K_B), D343.4 (K_B), D363.4 (K_B), D383.4 (K_B)
COL_B_04: D4.4 (K_B), D24.4 (K_B), D44.4 (K_B), D64.4 (K_B), D84.4 (K_B), D104.4 (K_B), D124.4 (K_B), D144.4 (K_B), D164.4 (K_B), D184.4 (K_B), D204.4 (K_B), D224.4 (K_B), D244.4 (K_B), D264.4 (K_B), D284.4 (K_B), D304.4 (K_B), D324.4 (K_B), D344.4 (K_B), D364.4 (K_B), D384.4 (K_B)
COL_B_05: D5.4 (K_B), D25.4 (K_B), D45.4 (K_B), D65.4 (K_B), D85.4 (K_B), D105.4 (K_B), D125.4 (K_B), D145.4 (K_B), D165.4 (K_B), D185.4 (K_B), D205.4 (K_B), D225.4 (K_B), D245.4 (K_B), D265.4 (K_B), D285.4 (K_B), D305.4 (K_B), D325.4 (K_B), D345.4 (K_B), D365.4 (K_B), D385.4 (K_B)
COL_B_06: D6.4 (K_B), D26.4 (K_B), D46.4 (K_B), D66.4 (K_B), D86.4 (K_B), D106.4 (K_B), D126.4 (K_B), D146.4 (K_B), D166.4 (K_B), D186.4 (K_B), D206.4 (K_B), D226.4 (K_B), D246.4 (K_B), D266.4 (K_B), D286.4 (K_B), D306.4 (K_B), D326.4 (K_B), D346.4 (K_B), D366.4 (K_B), D386.4 (K_B)
COL_B_07: D7.4 (K_B), D27.4 (K_B), D47.4 (K_B), D67.4 (K_B), D87.4 (K_B), D107.4 (K_B), D127.4 (K_B), D147.4 (K_B), D167.4 (K_B), D187.4 (K_B), D207.4 (K_B), D227.4 (K_B), D247.4 (K_B), D267.4 (K_B), D287.4 (K_B), D307.4 (K_B), D327.4 (K_B), D347.4 (K_B), D367.4 (K_B), D387.4 (K_B)
COL_B_08: D8.4 (K_B), D28.4 (K_B), D48.4 (K_B), D68.4 (K_B), D88.4 (K_B), D108.4 (K_B), D128.4 (K_B), D148.4 (K_B), D168.4 (K_B), D188.4 (K_B), D208.4 (K_B), D228.4 (K_B), D248.4 (K_B), D268.4 (K_B), D288.4 (K_B), D308.4 (K_B), D328.4 (K_B), D348.4 (K_B), D368.4 (K_B), D388.4 (K_B)
COL_B_09: D9.4 (K_B), D29.4 (K_B), D49.4 (K_B), D69.4 (K_B), D89.4 (K_B), D109.4 (K_B), D129.4 (K_B), D149.4 (K_B), D169.4 (K_B), D189.4 (K_B), D209.4 (K_B), D229.4 (K_B), D249.4 (K_B), D269.4 (K_B), D289.4 (K_B), D309.4 (K_B), D329.4 (K_B), D349.4 (K_B), D369.4 (K_B), D389.4 (K_B)
COL_B_10: D10.4 (K_B), D30.4 (K_B), D50.4 (K_B), D70.4 (K_B), D90.4 (K_B), D110.4 (K_B), D130.4 (K_B), D150.4 (K_B), D170.4 (K_B), D190.4 (K_B), D210.4 (K_B), D230.4 (K_B), D250.4 (K_B), D270.4 (K_B), D290.4 (K_B), D310.4 (K_B), D330.4 (K_B), D350.4 (K_B), D370.4 (K_B), D390.4 (K_B)
COL_B_11: D11.4 (K_B), D31.4 (K_B), D51.4 (K_B), D71.4 (K_B), D91.4 (K_B), D111.4 (K_B), D131.4 (K_B), D151.4 (K_B), D171.4 (K_B), D191.4 (K_B), D211.4 (K_B), D231.4 (K_B), D251.4 (K_B), D271.4 (K_B), D291.4 (K_B), D311.4 (K_B), D331.4 (K_B), D351.4 (K_B), D371.4 (K_B), D391.4 (K_B)
COL_B_12: D12.4 (K_B), D32.4 (K_B), D52.4 (K_B), D72.4 (K_B), D92.4 (K_B), D112.4 (K_B), D132.4 (K_B), D152.4 (K_B), D172.4 (K_B), D192.4 (K_B), D212.4 (K_B), D232.4 (K_B), D252.4 (K_B), D272.4 (K_B), D292.4 (K_B), D312.4 (K_B), D332.4 (K_B), D352.4 (K_B), D372.4 (K_B), D392.4 (K_B)
COL_B_13: D13.4 (K_B), D33.4 (K_B), D53.4 (K_B), D73.4 (K_B), D93.4 (K_B), D113.4 (K_B), D133.4 (K_B), D153.4 (K_B), D173.4 (K_B), D193.4 (K_B), D213.4 (K_B), D233.4 (K_B), D253.4 (K_B), D273.4 (K_B), D293.4 (K_B), D313.4 (K_B), D333.4 (K_B), D353.4 (K_B), D373.4 (K_B), D393.4 (K_B)
COL_B_14: D14.4 (K_B), D34.4 (K_B), D54.4 (K_B), D74.4 (K_B), D94.4 (K_B), D114.4 (K_B), D134.4 (K_B), D154.4 (K_B), D174.4 (K_B), D194.4 (K_B), D214.4 (K_B), D234.4 (K_B), D254.4 (K_B), D274.4 (K_B), D294.4 (K_B), D314.4 (K_B), D334.4 (K_B), D354.4 (K_B), D374.4 (K_B), D394.4 (K_B)
COL_B_15: D15.4 (K_B), D35.4 (K_B), D55.4 (K_B), D75.4 (K_B), D95.4 (K_B), D115.4 (K_B), D135.4 (K_B), D155.4 (K_B), D175.4 (K_B), D195.4 (K_B), D215.4 (K_B), D235.4 (K_B), D255.4 (K_B), D275.4 (K_B), D295.4 (K_B), D315.4 (K_B), D335.4 (K_B), D355.4 (K_B), D375.4 (K_B), D395.4 (K_B)
COL_B_16: D16.4 (K_B), D36.4 (K_B), D56.4 (K_B), D76.4 (K_B), D96.4 (K_B), D116.4 (K_B), D136.4 (K_B), D156.4 (K_B), D176.4 (K_B), D196.4 (K_B), D216.4 (K_B), D236.4 (K_B), D256.4 (K_B), D276.4 (K_B), D296.4 (K_B), D316.4 (K_B), D336.4 (K_B), D356.4 (K_B), D376.4 (K_B), D396.4 (K_B)
COL_B_17: D17.4 (K_B), D37.4 (K_B), D57.4 (K_B), D77.4 (K_B), D97.4 (K_B), D117.4 (K_B), D137.4 (K_B), D157.4 (K_B), D177.4 (K_B), D197.4 (K_B), D217.4 (K_B), D237.4 (K_B), D257.4 (K_B), D277.4 (K_B), D297.4 (K_B), D317.4 (K_B), D337.4 (K_B), D357.4 (K_B), D377.4 (K_B), D397.4 (K_B)
COL_B_18: D18.4 (K_B), D38.4 (K_B), D58.4 (K_B), D78.4 (K_B), D98.4 (K_B), D118.4 (K_B), D138.4 (K_B), D158.4 (K_B), D178.4 (K_B), D198.4 (K_B), D218.4 (K_B), D238.4 (K_B), D258.4 (K_B), D278.4 (K_B), D298.4 (K_B), D318.4 (K_B), D338.4 (K_B), D358.4 (K_B), D378.4 (K_B), D398.4 (K_B)
COL_B_19: D19.4 (K_B), D39.4 (K_B), D59.4 (K_B), D79.4 (K_B), D99.4 (K_B), D119.4 (K_B), D139.4 (K_B), D159.4 (K_B), D179.4 (K_B), D199.4 (K_B), D219.4 (K_B), D239.4 (K_B), D259.4 (K_B), D279.4 (K_B), D299.4 (K_B), D319.4 (K_B), D339.4 (K_B), D359.4 (K_B), D379.4 (K_B), D399.4 (K_B)
COL_B_20: D20.4 (K_B), D40.4 (K_B), D60.4 (K_B), D80.4 (K_B), D100.4 (K_B), D120.4 (K_B), D140.4 (K_B), D160.4 (K_B), D180.4 (K_B), D200.4 (K_B), D220.4 (K_B), D240.4 (K_B), D260.4 (K_B), D280.4 (K_B), D300.4 (K_B), D320.4 (K_B), D340.4 (K_B), D360.4 (K_B), D380.4 (K_B), D400.4 (K_B)
COL_G_01: D1.3 (K_G), D21.3 (K_G), D41.3 (K_G), D61.3 (K_G), D81.3 (K_G), D101.3 (K_G), D121.3 (K_G), D141.3 (K_G), D161.3 (K_G), D181.3 (K_G), D201.3 (K_G), D221.3 (K_G), D241.3 (K_G), D261.3 (K_G), D281.3 (K_G), D301.3 (K_G), D321.3 (K_G), D341.3 (K_G), D361.3 (K_G), D381.3 (K_G)
COL_G_02: D2.3 (K_G), D22.3 (K_G), D42.3 (K_G), D62.3 (K_G), D82.3 (K_G), D102.3 (K_G), D122.3 (K_G), D142.3 (K_G), D162.3 (K_G), D182.3 (K_G), D202.3 (K_G), D222.3 (K_G), D242.3 (K_G), D262.3 (K_G), D282.3 (K_G), D302.3 (K_G), D322.3 (K_G), D342.3 (K_G), D362.3 (K_G), D382.3 (K_G)
COL_G_03: D3.3 (K_G), D23.3 (K_G), D43.3 (K_G), D63.3 (K_G), D83.3 (K_G), D103.3 (K_G), D123.3 (K_G), D143.3 (K_G), D163.3 (K_G), D183.3 (K_G), D203.3 (K_G), D223.3 (K_G), D243.3 (K_G), D263.3 (K_G), D283.3 (K_G), D303.3 (K_G), D323.3 (K_G), D343.3 (K_G), D363.3 (K_G), D383.3 (K_G)
COL_G_04: D4.3 (K_G), D24.3 (K_G), D44.3 (K_G), D64.3 (K_G), D84.3 (K_G), D104.3 (K_G), D124.3 (K_G), D144.3 (K_G), D164.3 (K_G), D184.3 (K_G), D204.3 (K_G), D224.3 (K_G), D244.3 (K_G), D264.3 (K_G), D284.3 (K_G), D304.3 (K_G), D324.3 (K_G), D344.3 (K_G), D364.3 (K_G), D384.3 (K_G)
COL_G_05: D5.3 (K_G), D25.3 (K_G), D45.3 (K_G), D65.3 (K_G), D85.3 (K_G), D105.3 (K_G), D125.3 (K_G), D145.3 (K_G), D165.3 (K_G), D185.3 (K_G), D205.3 (K_G), D225.3 (K_G), D245.3 (K_G), D265.3 (K_G), D285.3 (K_G), D305.3 (K_G), D325.3 (K_G), D345.3 (K_G), D365.3 (K_G), D385.3 (K_G)
COL_G_06: D6.3 (K_G), D26.3 (K_G), D46.3 (K_G), D66.3 (K_G), D86.3 (K_G), D106.3 (K_G), D126.3 (K_G), D146.3 (K_G), D166.3 (K_G), D186.3 (K_G), D206.3 (K_G), D226.3 (K_G), D246.3 (K_G), D266.3 (K_G), D286.3 (K_G), D306.3 (K_G), D326.3 (K_G), D346.3 (K_G), D366.3 (K_G), D386.3 (K_G)
COL_G_07: D7.3 (K_G), D27.3 (K_G), D47.3 (K_G), D67.3 (K_G), D87.3 (K_G), D107.3 (K_G), D127.3 (K_G), D147.3 (K_G), D167.3 (K_G), D187.3 (K_G), D207.3 (K_G), D227.3 (K_G), D247.3 (K_G), D267.3 (K_G), D287.3 (K_G), D307.3 (K_G), D327.3 (K_G), D347.3 (K_G), D367.3 (K_G), D387.3 (K_G)
COL_G_08: D8.3 (K_G), D28.3 (K_G), D48.3 (K_G), D68.3 (K_G), D88.3 (K_G), D108.3 (K_G), D128.3 (K_G), D148.3 (K_G), D168.3 (K_G), D188.3 (K_G), D208.3 (K_G), D228.3 (K_G), D248.3 (K_G), D268.3 (K_G), D288.3 (K_G), D308.3 (K_G), D328.3 (K_G), D348.3 (K_G), D368.3 (K_G), D388.3 (K_G)
COL_G_09: D9.3 (K_G), D29.3 (K_G), D49.3 (K_G), D69.3 (K_G), D89.3 (K_G), D109.3 (K_G), D129.3 (K_G), D149.3 (K_G), D169.3 (K_G), D189.3 (K_G), D209.3 (K_G), D229.3 (K_G), D249.3 (K_G), D269.3 (K_G), D289.3 (K_G), D309.3 (K_G), D329.3 (K_G), D349.3 (K_G), D369.3 (K_G), D389.3 (K_G)
COL_G_10: D10.3 (K_G), D30.3 (K_G), D50.3 (K_G), D70.3 (K_G), D90.3 (K_G), D110.3 (K_G), D130.3 (K_G), D150.3 (K_G), D170.3 (K_G), D190.3 (K_G), D210.3 (K_G), D230.3 (K_G), D250.3 (K_G), D270.3 (K_G), D290.3 (K_G), D310.3 (K_G), D330.3 (K_G), D350.3 (K_G), D370.3 (K_G), D390.3 (K_G)
COL_G_11: D11.3 (K_G), D31.3 (K_G), D51.3 (K_G), D71.3 (K_G), D91.3 (K_G), D111.3 (K_G), D131.3 (K_G), D151.3 (K_G), D171.3 (K_G), D191.3 (K_G), D211.3 (K_G), D231.3 (K_G), D251.3 (K_G), D271.3 (K_G), D291.3 (K_G), D311.3 (K_G), D331.3 (K_G), D351.3 (K_G), D371.3 (K_G), D391.3 (K_G)
COL_G_12: D12.3 (K_G), D32.3 (K_G), D52.3 (K_G), D72.3 (K_G), D92.3 (K_G), D112.3 (K_G), D132.3 (K_G), D152.3 (K_G), D172.3 (K_G), D192.3 (K_G), D212.3 (K_G), D232.3 (K_G), D252.3 (K_G), D272.3 (K_G), D292.3 (K_G), D312.3 (K_G), D332.3 (K_G), D352.3 (K_G), D372.3 (K_G), D392.3 (K_G)
COL_G_13: D13.3 (K_G), D33.3 (K_G), D53.3 (K_G), D73.3 (K_G), D93.3 (K_G), D113.3 (K_G), D133.3 (K_G), D153.3 (K_G), D173.3 (K_G), D193.3 (K_G), D213.3 (K_G), D233.3 (K_G), D253.3 (K_G), D273.3 (K_G), D293.3 (K_G), D313.3 (K_G), D333.3 (K_G), D353.3 (K_G), D373.3 (K_G), D393.3 (K_G)
COL_G_14: D14.3 (K_G), D34.3 (K_G), D54.3 (K_G), D74.3 (K_G), D94.3 (K_G), D114.3 (K_G), D134.3 (K_G), D154.3 (K_G), D174.3 (K_G), D194.3 (K_G), D214.3 (K_G), D234.3 (K_G), D254.3 (K_G), D274.3 (K_G), D294.3 (K_G), D314.3 (K_G), D334.3 (K_G), D354.3 (K_G), D374.3 (K_G), D394.3 (K_G)
COL_G_15: D15.3 (K_G), D35.3 (K_G), D55.3 (K_G), D75.3 (K_G), D95.3 (K_G), D115.3 (K_G), D135.3 (K_G), D155.3 (K_G), D175.3 (K_G), D195.3 (K_G), D215.3 (K_G), D235.3 (K_G), D255.3 (K_G), D275.3 (K_G), D295.3 (K_G), D315.3 (K_G), D335.3 (K_G), D355.3 (K_G), D375.3 (K_G), D395.3 (K_G)
COL_G_16: D16.3 (K_G), D36.3 (K_G), D56.3 (K_G), D76.3 (K_G), D96.3 (K_G), D116.3 (K_G), D136.3 (K_G), D156.3 (K_G), D176.3 (K_G), D196.3 (K_G), D216.3 (K_G), D236.3 (K_G), D256.3 (K_G), D276.3 (K_G), D296.3 (K_G), D316.3 (K_G), D336.3 (K_G), D356.3 (K_G), D376.3 (K_G), D396.3 (K_G)
COL_G_17: D17.3 (K_G), D37.3 (K_G), D57.3 (K_G), D77.3 (K_G), D97.3 (K_G), D117.3 (K_G), D137.3 (K_G), D157.3 (K_G), D177.3 (K_G), D197.3 (K_G), D217.3 (K_G), D237.3 (K_G), D257.3 (K_G), D277.3 (K_G), D297.3 (K_G), D317.3 (K_G), D337.3 (K_G), D357.3 (K_G), D377.3 (K_G), D397.3 (K_G)
COL_G_18: D18.3 (K_G), D38.3 (K_G), D58.3 (K_G), D78.3 (K_G), D98.3 (K_G), D118.3 (K_G), D138.3 (K_G), D158.3 (K_G), D178.3 (K_G), D198.3 (K_G), D218.3 (K_G), D238.3 (K_G), D258.3 (K_G), D278.3 (K_G), D298.3 (K_G), D318.3 (K_G), D338.3 (K_G), D358.3 (K_G), D378.3 (K_G), D398.3 (K_G)
COL_G_19: D19.3 (K_G), D39.3 (K_G), D59.3 (K_G), D79.3 (K_G), D99.3 (K_G), D119.3 (K_G), D139.3 (K_G), D159.3 (K_G), D179.3 (K_G), D199.3 (K_G), D219.3 (K_G), D239.3 (K_G), D259.3 (K_G), D279.3 (K_G), D299.3 (K_G), D319.3 (K_G), D339.3 (K_G), D359.3 (K_G), D379.3 (K_G), D399.3 (K_G)
COL_G_20: D20.3 (K_G), D40.3 (K_G), D60.3 (K_G), D80.3 (K_G), D100.3 (K_G), D120.3 (K_G), D140.3 (K_G), D160.3 (K_G), D180.3 (K_G), D200.3 (K_G), D220.3 (K_G), D240.3 (K_G), D260.3 (K_G), D280.3 (K_G), D300.3 (K_G), D320.3 (K_G), D340.3 (K_G), D360.3 (K_G), D380.3 (K_G), D400.3 (K_G)
COL_R_01: D1.2 (K_R), D21.2 (K_R), D41.2 (K_R), D61.2 (K_R), D81.2 (K_R), D101.2 (K_R), D121.2 (K_R), D141.2 (K_R), D161.2 (K_R), D181.2 (K_R), D201.2 (K_R), D221.2 (K_R), D241.2 (K_R), D261.2 (K_R), D281.2 (K_R), D301.2 (K_R), D321.2 (K_R), D341.2 (K_R), D361.2 (K_R), D381.2 (K_R)
COL_R_02: D2.2 (K_R), D22.2 (K_R), D42.2 (K_R), D62.2 (K_R), D82.2 (K_R), D102.2 (K_R), D122.2 (K_R), D142.2 (K_R), D162.2 (K_R), D182.2 (K_R), D202.2 (K_R), D222.2 (K_R), D242.2 (K_R), D262.2 (K_R), D282.2 (K_R), D302.2 (K_R), D322.2 (K_R), D342.2 (K_R), D362.2 (K_R), D382.2 (K_R)
COL_R_03: D3.2 (K_R), D23.2 (K_R), D43.2 (K_R), D63.2 (K_R), D83.2 (K_R), D103.2 (K_R), D123.2 (K_R), D143.2 (K_R), D163.2 (K_R), D183.2 (K_R), D203.2 (K_R), D223.2 (K_R), D243.2 (K_R), D263.2 (K_R), D283.2 (K_R), D303.2 (K_R), D323.2 (K_R), D343.2 (K_R), D363.2 (K_R), D383.2 (K_R)
COL_R_04: D4.2 (K_R), D24.2 (K_R), D44.2 (K_R), D64.2 (K_R), D84.2 (K_R), D104.2 (K_R), D124.2 (K_R), D144.2 (K_R), D164.2 (K_R), D184.2 (K_R), D204.2 (K_R), D224.2 (K_R), D244.2 (K_R), D264.2 (K_R), D284.2 (K_R), D304.2 (K_R), D324.2 (K_R), D344.2 (K_R), D364.2 (K_R), D384.2 (K_R)
COL_R_05: D5.2 (K_R), D25.2 (K_R), D45.2 (K_R), D65.2 (K_R), D85.2 (K_R), D105.2 (K_R), D125.2 (K_R), D145.2 (K_R), D165.2 (K_R), D185.2 (K_R), D205.2 (K_R), D225.2 (K_R), D245.2 (K_R), D265.2 (K_R), D285.2 (K_R), D305.2 (K_R), D325.2 (K_R), D345.2 (K_R), D365.2 (K_R), D385.2 (K_R)
COL_R_06: D6.2 (K_R), D26.2 (K_R), D46.2 (K_R), D66.2 (K_R), D86.2 (K_R), D106.2 (K_R), D126.2 (K_R), D146.2 (K_R), D166.2 (K_R), D186.2 (K_R), D206.2 (K_R), D226.2 (K_R), D246.2 (K_R), D266.2 (K_R), D286.2 (K_R), D306.2 (K_R), D326.2 (K_R), D346.2 (K_R), D366.2 (K_R), D386.2 (K_R)
COL_R_07: D7.2 (K_R), D27.2 (K_R), D47.2 (K_R), D67.2 (K_R), D87.2 (K_R), D107.2 (K_R), D127.2 (K_R), D147.2 (K_R), D167.2 (K_R), D187.2 (K_R), D207.2 (K_R), D227.2 (K_R), D247.2 (K_R), D267.2 (K_R), D287.2 (K_R), D307.2 (K_R), D327.2 (K_R), D347.2 (K_R), D367.2 (K_R), D387.2 (K_R)
COL_R_08: D8.2 (K_R), D28.2 (K_R), D48.2 (K_R), D68.2 (K_R), D88.2 (K_R), D108.2 (K_R), D128.2 (K_R), D148.2 (K_R), D168.2 (K_R), D188.2 (K_R), D208.2 (K_R), D228.2 (K_R), D248.2 (K_R), D268.2 (K_R), D288.2 (K_R), D308.2 (K_R), D328.2 (K_R), D348.2 (K_R), D368.2 (K_R), D388.2 (K_R)
COL_R_09: D9.2 (K_R), D29.2 (K_R), D49.2 (K_R), D69.2 (K_R), D89.2 (K_R), D109.2 (K_R), D129.2 (K_R), D149.2 (K_R), D169.2 (K_R), D189.2 (K_R), D209.2 (K_R), D229.2 (K_R), D249.2 (K_R), D269.2 (K_R), D289.2 (K_R), D309.2 (K_R), D329.2 (K_R), D349.2 (K_R), D369.2 (K_R), D389.2 (K_R)
COL_R_10: D10.2 (K_R), D30.2 (K_R), D50.2 (K_R), D70.2 (K_R), D90.2 (K_R), D110.2 (K_R), D130.2 (K_R), D150.2 (K_R), D170.2 (K_R), D190.2 (K_R), D210.2 (K_R), D230.2 (K_R), D250.2 (K_R), D270.2 (K_R), D290.2 (K_R), D310.2 (K_R), D330.2 (K_R), D350.2 (K_R), D370.2 (K_R), D390.2 (K_R)
COL_R_11: D11.2 (K_R), D31.2 (K_R), D51.2 (K_R), D71.2 (K_R), D91.2 (K_R), D111.2 (K_R), D131.2 (K_R), D151.2 (K_R), D171.2 (K_R), D191.2 (K_R), D211.2 (K_R), D231.2 (K_R), D251.2 (K_R), D271.2 (K_R), D291.2 (K_R), D311.2 (K_R), D331.2 (K_R), D351.2 (K_R), D371.2 (K_R), D391.2 (K_R)
COL_R_12: D12.2 (K_R), D32.2 (K_R), D52.2 (K_R), D72.2 (K_R), D92.2 (K_R), D112.2 (K_R), D132.2 (K_R), D152.2 (K_R), D172.2 (K_R), D192.2 (K_R), D212.2 (K_R), D232.2 (K_R), D252.2 (K_R), D272.2 (K_R), D292.2 (K_R), D312.2 (K_R), D332.2 (K_R), D352.2 (K_R), D372.2 (K_R), D392.2 (K_R)
COL_R_13: D13.2 (K_R), D33.2 (K_R), D53.2 (K_R), D73.2 (K_R), D93.2 (K_R), D113.2 (K_R), D133.2 (K_R), D153.2 (K_R), D173.2 (K_R), D193.2 (K_R), D213.2 (K_R), D233.2 (K_R), D253.2 (K_R), D273.2 (K_R), D293.2 (K_R), D313.2 (K_R), D333.2 (K_R), D353.2 (K_R), D373.2 (K_R), D393.2 (K_R)
COL_R_14: D14.2 (K_R), D34.2 (K_R), D54.2 (K_R), D74.2 (K_R), D94.2 (K_R), D114.2 (K_R), D134.2 (K_R), D154.2 (K_R), D174.2 (K_R), D194.2 (K_R), D214.2 (K_R), D234.2 (K_R), D254.2 (K_R), D274.2 (K_R), D294.2 (K_R), D314.2 (K_R), D334.2 (K_R), D354.2 (K_R), D374.2 (K_R), D394.2 (K_R)
COL_R_15: D15.2 (K_R), D35.2 (K_R), D55.2 (K_R), D75.2 (K_R), D95.2 (K_R), D115.2 (K_R), D135.2 (K_R), D155.2 (K_R), D175.2 (K_R), D195.2 (K_R), D215.2 (K_R), D235.2 (K_R), D255.2 (K_R), D275.2 (K_R), D295.2 (K_R), D315.2 (K_R), D335.2 (K_R), D355.2 (K_R), D375.2 (K_R), D395.2 (K_R)
COL_R_16: D16.2 (K_R), D36.2 (K_R), D56.2 (K_R), D76.2 (K_R), D96.2 (K_R), D116.2 (K_R), D136.2 (K_R), D156.2 (K_R), D176.2 (K_R), D196.2 (K_R), D216.2 (K_R), D236.2 (K_R), D256.2 (K_R), D276.2 (K_R), D296.2 (K_R), D316.2 (K_R), D336.2 (K_R), D356.2 (K_R), D376.2 (K_R), D396.2 (K_R)
COL_R_17: D17.2 (K_R), D37.2 (K_R), D57.2 (K_R), D77.2 (K_R), D97.2 (K_R), D117.2 (K_R), D137.2 (K_R), D157.2 (K_R), D177.2 (K_R), D197.2 (K_R), D217.2 (K_R), D237.2 (K_R), D257.2 (K_R), D277.2 (K_R), D297.2 (K_R), D317.2 (K_R), D337.2 (K_R), D357.2 (K_R), D377.2 (K_R), D397.2 (K_R)
COL_R_18: D18.2 (K_R), D38.2 (K_R), D58.2 (K_R), D78.2 (K_R), D98.2 (K_R), D118.2 (K_R), D138.2 (K_R), D158.2 (K_R), D178.2 (K_R), D198.2 (K_R), D218.2 (K_R), D238.2 (K_R), D258.2 (K_R), D278.2 (K_R), D298.2 (K_R), D318.2 (K_R), D338.2 (K_R), D358.2 (K_R), D378.2 (K_R), D398.2 (K_R)
COL_R_19: D19.2 (K_R), D39.2 (K_R), D59.2 (K_R), D79.2 (K_R), D99.2 (K_R), D119.2 (K_R), D139.2 (K_R), D159.2 (K_R), D179.2 (K_R), D199.2 (K_R), D219.2 (K_R), D239.2 (K_R), D259.2 (K_R), D279.2 (K_R), D299.2 (K_R), D319.2 (K_R), D339.2 (K_R), D359.2 (K_R), D379.2 (K_R), D399.2 (K_R)
COL_R_20: D20.2 (K_R), D40.2 (K_R), D60.2 (K_R), D80.2 (K_R), D100.2 (K_R), D120.2 (K_R), D140.2 (K_R), D160.2 (K_R), D180.2 (K_R), D200.2 (K_R), D220.2 (K_R), D240.2 (K_R), D260.2 (K_R), D280.2 (K_R), D300.2 (K_R), D320.2 (K_R), D340.2 (K_R), D360.2 (K_R), D380.2 (K_R), D400.2 (K_R)
ROW_01_ANODE: D1.1 (A), D2.1 (A), D3.1 (A), D4.1 (A), D5.1 (A), D6.1 (A), D7.1 (A), D8.1 (A), D9.1 (A), D10.1 (A), D11.1 (A), D12.1 (A), D13.1 (A), D14.1 (A), D15.1 (A), D16.1 (A), D17.1 (A), D18.1 (A), D19.1 (A), D20.1 (A)
ROW_02_ANODE: D21.1 (A), D22.1 (A), D23.1 (A), D24.1 (A), D25.1 (A), D26.1 (A), D27.1 (A), D28.1 (A), D29.1 (A), D30.1 (A), D31.1 (A), D32.1 (A), D33.1 (A), D34.1 (A), D35.1 (A), D36.1 (A), D37.1 (A), D38.1 (A), D39.1 (A), D40.1 (A)
ROW_03_ANODE: D41.1 (A), D42.1 (A), D43.1 (A), D44.1 (A), D45.1 (A), D46.1 (A), D47.1 (A), D48.1 (A), D49.1 (A), D50.1 (A), D51.1 (A), D52.1 (A), D53.1 (A), D54.1 (A), D55.1 (A), D56.1 (A), D57.1 (A), D58.1 (A), D59.1 (A), D60.1 (A)
ROW_04_ANODE: D61.1 (A), D62.1 (A), D63.1 (A), D64.1 (A), D65.1 (A), D66.1 (A), D67.1 (A), D68.1 (A), D69.1 (A), D70.1 (A), D71.1 (A), D72.1 (A), D73.1 (A), D74.1 (A), D75.1 (A), D76.1 (A), D77.1 (A), D78.1 (A), D79.1 (A), D80.1 (A)
ROW_05_ANODE: D81.1 (A), D82.1 (A), D83.1 (A), D84.1 (A), D85.1 (A), D86.1 (A), D87.1 (A), D88.1 (A), D89.1 (A), D90.1 (A), D91.1 (A), D92.1 (A), D93.1 (A), D94.1 (A), D95.1 (A), D96.1 (A), D97.1 (A), D98.1 (A), D99.1 (A), D100.1 (A)
ROW_06_ANODE: D101.1 (A), D102.1 (A), D103.1 (A), D104.1 (A), D105.1 (A), D106.1 (A), D107.1 (A), D108.1 (A), D109.1 (A), D110.1 (A), D111.1 (A), D112.1 (A), D113.1 (A), D114.1 (A), D115.1 (A), D116.1 (A), D117.1 (A), D118.1 (A), D119.1 (A), D120.1 (A)
ROW_07_ANODE: D121.1 (A), D122.1 (A), D123.1 (A), D124.1 (A), D125.1 (A), D126.1 (A), D127.1 (A), D128.1 (A), D129.1 (A), D130.1 (A), D131.1 (A), D132.1 (A), D133.1 (A), D134.1 (A), D135.1 (A), D136.1 (A), D137.1 (A), D138.1 (A), D139.1 (A), D140.1 (A)
ROW_08_ANODE: D141.1 (A), D142.1 (A), D143.1 (A), D144.1 (A), D145.1 (A), D146.1 (A), D147.1 (A), D148.1 (A), D149.1 (A), D150.1 (A), D151.1 (A), D152.1 (A), D153.1 (A), D154.1 (A), D155.1 (A), D156.1 (A), D157.1 (A), D158.1 (A), D159.1 (A), D160.1 (A)
ROW_09_ANODE: D161.1 (A), D162.1 (A), D163.1 (A), D164.1 (A), D165.1 (A), D166.1 (A), D167.1 (A), D168.1 (A), D169.1 (A), D170.1 (A), D171.1 (A), D172.1 (A), D173.1 (A), D174.1 (A), D175.1 (A), D176.1 (A), D177.1 (A), D178.1 (A), D179.1 (A), D180.1 (A)
ROW_10_ANODE: D181.1 (A), D182.1 (A), D183.1 (A), D184.1 (A), D185.1 (A), D186.1 (A), D187.1 (A), D188.1 (A), D189.1 (A), D190.1 (A), D191.1 (A), D192.1 (A), D193.1 (A), D194.1 (A), D195.1 (A), D196.1 (A), D197.1 (A), D198.1 (A), D199.1 (A), D200.1 (A)
ROW_11_ANODE: D201.1 (A), D202.1 (A), D203.1 (A), D204.1 (A), D205.1 (A), D206.1 (A), D207.1 (A), D208.1 (A), D209.1 (A), D210.1 (A), D211.1 (A), D212.1 (A), D213.1 (A), D214.1 (A), D215.1 (A), D216.1 (A), D217.1 (A), D218.1 (A), D219.1 (A), D220.1 (A)
ROW_12_ANODE: D221.1 (A), D222.1 (A), D223.1 (A), D224.1 (A), D225.1 (A), D226.1 (A), D227.1 (A), D228.1 (A), D229.1 (A), D230.1 (A), D231.1 (A), D232.1 (A), D233.1 (A), D234.1 (A), D235.1 (A), D236.1 (A), D237.1 (A), D238.1 (A), D239.1 (A), D240.1 (A)
ROW_13_ANODE: D241.1 (A), D242.1 (A), D243.1 (A), D244.1 (A), D245.1 (A), D246.1 (A), D247.1 (A), D248.1 (A), D249.1 (A), D250.1 (A), D251.1 (A), D252.1 (A), D253.1 (A), D254.1 (A), D255.1 (A), D256.1 (A), D257.1 (A), D258.1 (A), D259.1 (A), D260.1 (A)
ROW_14_ANODE: D261.1 (A), D262.1 (A), D263.1 (A), D264.1 (A), D265.1 (A), D266.1 (A), D267.1 (A), D268.1 (A), D269.1 (A), D270.1 (A), D271.1 (A), D272.1 (A), D273.1 (A), D274.1 (A), D275.1 (A), D276.1 (A), D277.1 (A), D278.1 (A), D279.1 (A), D280.1 (A)
ROW_15_ANODE: D281.1 (A), D282.1 (A), D283.1 (A), D284.1 (A), D285.1 (A), D286.1 (A), D287.1 (A), D288.1 (A), D289.1 (A), D290.1 (A), D291.1 (A), D292.1 (A), D293.1 (A), D294.1 (A), D295.1 (A), D296.1 (A), D297.1 (A), D298.1 (A), D299.1 (A), D300.1 (A)
ROW_16_ANODE: D301.1 (A), D302.1 (A), D303.1 (A), D304.1 (A), D305.1 (A), D306.1 (A), D307.1 (A), D308.1 (A), D309.1 (A), D310.1 (A), D311.1 (A), D312.1 (A), D313.1 (A), D314.1 (A), D315.1 (A), D316.1 (A), D317.1 (A), D318.1 (A), D319.1 (A), D320.1 (A)
ROW_17_ANODE: D321.1 (A), D322.1 (A), D323.1 (A), D324.1 (A), D325.1 (A), D326.1 (A), D327.1 (A), D328.1 (A), D329.1 (A), D330.1 (A), D331.1 (A), D332.1 (A), D333.1 (A), D334.1 (A), D335.1 (A), D336.1 (A), D337.1 (A), D338.1 (A), D339.1 (A), D340.1 (A)
ROW_18_ANODE: D341.1 (A), D342.1 (A), D343.1 (A), D344.1 (A), D345.1 (A), D346.1 (A), D347.1 (A), D348.1 (A), D349.1 (A), D350.1 (A), D351.1 (A), D352.1 (A), D353.1 (A), D354.1 (A), D355.1 (A), D356.1 (A), D357.1 (A), D358.1 (A), D359.1 (A), D360.1 (A)
ROW_19_ANODE: D361.1 (A), D362.1 (A), D363.1 (A), D364.1 (A), D365.1 (A), D366.1 (A), D367.1 (A), D368.1 (A), D369.1 (A), D370.1 (A), D371.1 (A), D372.1 (A), D373.1 (A), D374.1 (A), D375.1 (A), D376.1 (A), D377.1 (A), D378.1 (A), D379.1 (A), D380.1 (A)
ROW_20_ANODE: D381.1 (A), D382.1 (A), D383.1 (A), D384.1 (A), D385.1 (A), D386.1 (A), D387.1 (A), D388.1 (A), D389.1 (A), D390.1 (A), D391.1 (A), D392.1 (A), D393.1 (A), D394.1 (A), D395.1 (A), D396.1 (A), D397.1 (A), D398.1 (A), D399.1 (A), D400.1 (A)
