illiapliukhin/leds/(commit log)

2026-10-07 Establish wearable RGB PCB production baseline
    [WEARABLE_RGB_MVP_PRELIMINARY_BOM.csv, power_scan_results.csv, wearable_20x20.kicad_pcb, wearable_20x20_bottom_right_routing_probe.kicad_pcb, wearable_20x20_edge_routing_probe.kicad_pcb, wearable_28x28.kicad_pcb, wearable_28x28_bottom_right_routing_probe.kicad_pcb, wearable_28x28_edge_routing_probe.kicad_pcb]
2026-10-07 Add matrix orientation transition probe
2026-10-07 Validate matrix orientation transition routing
    [wearable_20x20_edge_routing_probe.kicad_pcb, wearable_20x20_orientation_transition_routing_probe.kicad_pcb, wearable_28x28_bottom_right_routing_probe.kicad_pcb, wearable_28x28_orientation_transition_routing_probe.kicad_pcb]
2026-10-07 Add mirrored matrix corner probes
2026-10-07 Validate remaining matrix corners
    [wearable_20x20_bottom_left_routing_probe.kicad_pcb, wearable_20x20_top_right_routing_probe.kicad_pcb, wearable_28x28_bottom_left_routing_probe.kicad_pcb, wearable_28x28_top_right_routing_probe.kicad_pcb]
2026-10-07 Add matrix column boundary probes
2026-10-07 Add matrix row boundary probes
2026-10-07 Verify all matrix orientation boundaries
    [wearable_20x20_bottom_left_column_boundary_routing_probe.kicad_pcb, wearable_20x20_bottom_left_row_boundary_routing_probe.kicad_pcb, wearable_20x20_top_right_column_boundary_routing_probe.kicad_pcb, wearable_20x20_top_right_row_boundary_routing_probe.kicad_pcb, wearable_28x28_bottom_left_column_boundary_routing_probe.kicad_pcb, wearable_28x28_bottom_left_row_boundary_routing_probe.kicad_pcb, wear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]
2026-10-07 Add DRC-clean full matrix routing artifacts
    [wearable_20x20_full_matrix_routing.kicad_pcb, wearable_28x28_full_matrix_routing.kicad_pcb]
2026-10-07 Correct RGB matrix driver architecture
    [WEARABLE_RGB_MVP_PRELIMINARY_BOM.csv, power_scan_results.csv]
2026-10-07 Add worst-case LED current margin
    [WEARABLE_RGB_MVP_PRELIMINARY_BOM.csv, power_scan_results.csv]
2026-10-07 Add isolated LED driver readback path
    [WEARABLE_RGB_MVP_PRELIMINARY_BOM.csv]
2026-10-07 Generate LED driver schematics
    [led_drivers.kicad_sch]
2026-10-07 Add standalone ERC harnesses
    [led_drivers.kicad_sch]
2026-10-07 Add KiCad project context for ERC
    [led_drivers.kicad_sch]
2026-10-07 Document verified LED driver projects
2026-10-07 Generate RGB LED matrix schematics
    [led_matrix.kicad_sch]
2026-10-07 Document verified LED matrix sheets
2026-10-07 Generate row selection schematics
    [row_selection.kicad_sch]
2026-10-07 Clarify unused translator input grounding
    [row_selection.kicad_sch]
2026-10-07 Preserve row resistor pin mapping
    [row_selection.kicad_sch]
2026-10-07 Separate row resistor label endpoints
    [row_selection.kicad_sch]
2026-10-07 Freeze mechanical inputs and RHL footprint
    [BOM_FREEZE_STATUS.csv, WEARABLE_RGB_MVP_PRELIMINARY_BOM.csv, row_selection.kicad_sch]
2026-10-07 Promote verified matrix routing and release gates
    [evt_measurements.csv, wearable_20x20.kicad_pcb, wearable_28x28.kicad_pcb]
2026-10-07 Generate complete conditional schematic hierarchy
    [audio.kicad_sch, imu_gauge_input.kicad_sch, led_drivers.kicad_sch, led_drivers_standalone_erc.kicad_sch, led_matrix.kicad_sch, mcu_usb.kicad_sch, power.kicad_sch, row_selection.kicad_sch]
2026-10-07 Correct BMI270 I2C strap semantics
    [imu_gauge_input.kicad_sch]
2026-10-07 Release verified charger and sensor footprints
    [BOM_FREEZE_STATUS.csv, WEARABLE_RGB_MVP_PRELIMINARY_BOM.csv, imu_gauge_input.kicad_sch, power.kicad_sch]
2026-10-07 Release exact TPS63802 HotRod footprint
    [BOM_FREEZE_STATUS.csv, WEARABLE_RGB_MVP_PRELIMINARY_BOM.csv, power.kicad_sch]
2026-10-07 Release crystal and power inductor packages
    [BOM_FREEZE_STATUS.csv, WEARABLE_RGB_MVP_PRELIMINARY_BOM.csv, mcu_usb.kicad_sch, power.kicad_sch]
2026-10-07 Probe 20x20 L2 ground plane continuity
    [wearable_20x20_l2_ground_plane_probe.kicad_pcb]
2026-10-07 Audit all schematic footprint pad mappings
2026-10-07 Select conditional EVT interface components
    [BOM_FREEZE_STATUS.csv, WEARABLE_RGB_MVP_PRELIMINARY_BOM.csv]
2026-10-07 Release button and microphone footprints
    [BOM_FREEZE_STATUS.csv, WEARABLE_RGB_MVP_PRELIMINARY_BOM.csv]
2026-10-07 Regenerate hierarchies with selected EVT parts
    [audio.kicad_sch, imu_gauge_input.kicad_sch, wearable_20x20.kicad_sch, wearable_28x28.kicad_sch]
2026-10-07 Screen production battery candidates
    [BOM_FREEZE_STATUS.csv, WEARABLE_RGB_MVP_PRELIMINARY_BOM.csv]
2026-10-07 Isolate generated PCB saves from project metadata
2026-10-07 Regenerate deterministic matrix PCB artifacts
    [wearable_20x20.kicad_pcb, wearable_20x20_full_matrix_routing.kicad_pcb, wearable_20x20_matrix_skeleton.kicad_pcb, wearable_28x28.kicad_pcb, wearable_28x28_full_matrix_routing.kicad_pcb, wearable_28x28_matrix_skeleton.kicad_pcb]
2026-10-07 Parameterize matrix edge via clamp
2026-10-07 Isolate edge routing probes
2026-10-08 Place 20x20 backside parts outside the via field
    [wearable_20x20.kicad_pcb, wearable_20x20_bottom_left_column_boundary_routing_probe.kicad_pcb, wearable_20x20_bottom_left_routing_probe.kicad_pcb, wearable_20x20_bottom_left_row_boundary_routing_probe.kicad_pcb, wearable_20x20_bottom_right_routing_probe.kicad_pcb, wearable_20x20_edge_routing_probe.kicad_pcb, wearable_20x20_full_matrix_routing.kicad_pcb, wearable_20x20_matrix_skeleton.kicad_pcb]
2026-10-08 Route the first 20x20 column and anode escapes.
    The border router stays on B.Cu and In2.Cu, leaves L2 empty, and connects 19 of 80 column/anode pads with zero DRC violations. The remaining driver pins are blocked by the 90-degree package gap, which fits one track.
    [wearable_20x20.kicad_pcb]
2026-10-08 Record a LED-only face and a stacked rear board.
    The visible panel stays the LED field. Parts that cannot sit on the through-via back go on a second board joined by a mating connector. The connector is not frozen, and the 75 mm single-board rim is not the product outline.
